katodo/pNav32_RobotMotorController/Hardware/hBridge3620_Rev1/Render/hBridge3620_Top_Normal.png

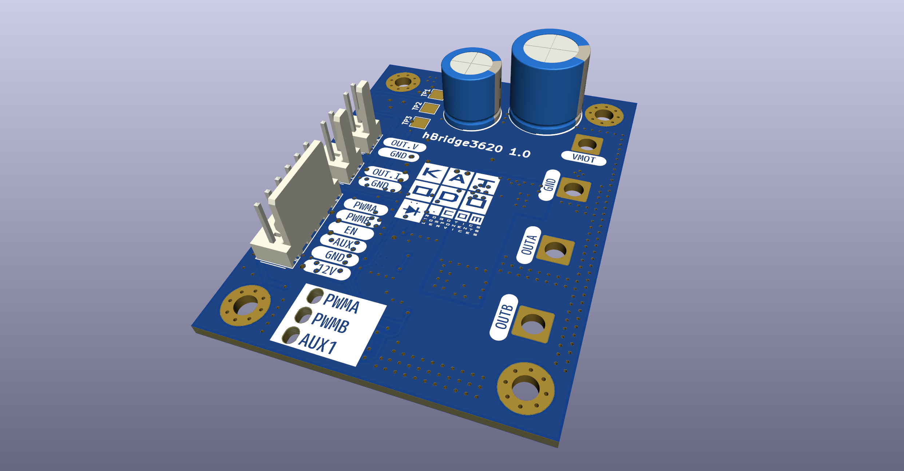
Hardware/hBridge3620_Rev1/Render/hBridge3620_Top_Normal.png
