katodo/pNav32_RobotMotorController/Hardware/RobotMotorController/Doc/F407VE板- LCD显示例程/readme.txt

本实验将实现如下功能：本实验利用STM32F407开发板连接TFTLCD模块，实现TFTLCD模块的显示，下载成功后，通过把LCD模块插入TFTLCD模块接口，按下复位之后，就可以看到LCD模块不停的显示一些信息并不断切换底色。同时该实验会显示LCD驱动器的ID，并且会在串口打印（按复位一次，打印一次）。
 
//STM32F4工程模板-库函数版本
//淘宝店铺：http://mcudev.taobao.com
