katodo/pNav32_RobotMotorController/Hardware/RobotMotorController/Doc/STM32_F4VE--核心板原理图 (EN).pdf

PIRST02

PIRST01

PIRST02

PIRST01

NLNRF0CS

PIQ201PIR3001

PIR2302PIJ305

NLPA100RXD1

NLFSMC0A18 | NLFSMC0NE1

NLFSMC0D3
NLFSMC0D1

NLFSMC0D9

NLPB30TDO

NLNRF0IRQ

NLFSMC0D5

NLPB13

NLPB10

PIJ306PIR3301

Reserve 5V input interface, connector spacing 2.54mm

STM32 working mode has been grounded by default: grounded through R7 and R8

To change the jumper cap insertion method, the board has a jumper cap by default

The jumper cap is inserted into the flash memory mode by default for the convenience of carrying the board.

It works normally, and the jumper cap does not need to be inserted. If you need other working modes, you can

NLFSMC0D15

## reset button

## LED indicator

## Power supply indicator

Power supply stabilized power supply

## User button

## STM32 working mode selection

## Real time clock battery backup

## ISP serial port download program interface

## TFT LCD screen interface

TIM4_ETR/FSMC_NBL0/PE0

3V3

104

2

10K

RST

6

PD2/UART5_RX/TIM3_ETR/SDIO_CMD

PA12/USB_DP

55

8

PB5

6

94

PE5

PB10

A

FSMC_D4

21 22

3

twenty one

9

VREF-

39 40

104

NRF_CS

OUT

68

PC10/USART4_TX/SDIO_D2/(USART3_TX)

3

PC11

PC11

KEY1

1M

104

0R

SDIO_D0

(I2C1_SDA/CANTX)/SDIO_D5/TIM4_CH4/PB9

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
FSMC_D13 PA6/ADC12_IN6/TIM3_CH1/TIM8_BKIN/SPI1_MISO/(TIM1_BKIN)

R12

D-

FSMC_NWE

TIM1_CH4/FSMC_D11/PE14

42

GND

PA5

GND

D2

VDD_2

32.768K

OSC_IN

PD5/FSMC_NWE/(USART2_TX)

VBAT

FSMC_D10

R16

C15

10K

5

PD2

R19 22

3V3

R9

FSMC_D7

80

9 10

2

RST

UART_TX

0

SW-PB

D+

PC13/TAMPER-RTC

PD1

RTCK

96

FSMC_D13

GND

3V3

500mA

21 22

TDO

FSMC_D7

PA9/USART1_TX/TIM1_CH2

FSMC_D1

PC8

PE11

J4

5

SPI2_NSS/I2S2_WS/I2S2_SMBA1/TIM1_BKIN/USART3_CK/PB12

15

3

PE15

75

VDD_5

C4

72

Q1

LASH_WP

DAT2

Vsupply

5

T_MISO

29 30

GND

TRACED0/FSMC_A19/PE3

FSMC_D14

5V

U2

48

Size

SPI1_SCK

VCC

NRF2401

T_SCK

PE1

88

NRST

PE3

33 34

PC2/ADC123_IN12

PD8

11

43 44

510R

45 46

3V3

GND

25

5 6

FSMC_NWE

PA10/RXD1

GND

PE0

7

1.5K

PA7

3

3

PA8

C12

1.5K

C:\Documents and Settings\..\STM32_F4VE.Sc Drawn B hDocy:

(TIM1_CH2N)/TIM8_CH2N/TIM3_CH3/AD12_IN8/PB0

PD15

82

VSS_4

PA11/USB_DM

R13

5V

6

4

PA4

51

41 42

4

PE6

37 38

RST

17 18

K_UP

TRACED3/FSMC_A22/PE6

PA6

FSMC_D2

4

FSMC_D10

7

PD13

PC3

PD8/FSMC_D13/(USART3_TX)

FSMC_D4

MiniSD

PB12

56

SPI1_MISO

PB3/TDO

PD9

PE6

PC5/ADC12_IN15

PE14

VCC

GND

R26

PA12/USB_DP

2017-10-24

CMD

led

95

3V3

GND

10K

SPI2_MOSI/TIM1_CH3N/PB15

FSMC_D11

6

R14

19 20

FSMC_D1

GND

PA12/USART1_RTS/TIM1_ETR/USBDP/CANTX 76

PC2

SPI1_SCK

TIM1_CH1/FSMC_D6/PE9

PA0/WK_UP

PB1

FSMC_D8

23 24

104

D1

GND

PD11/FSMC_A16/(USART3_CTS)

57

PC5

13 14

PE8

104

SPI1_MISO

1

SDIO_CMD

11 12

GND

104

VCAP_1

T_MOSI

GND

1

10K

PA15/TDI

PC9

PA1

BAT54C

8

twenty four

FSMC_D5

1

PD3

GND

(TIM3_CH1/SPI1_MISO)SPI3_MISO/JNTRST/PB4

T_SCK

PD15

SDIO_D3

PE12

R23

1 2

1

R6

92

PA2/ADC123_IN2/USART2_TX/TIM2_CH3/TIM5_CH3

1.5K

K0

15 16

35 36

3

PD14/FSMC_D0/(TIM4_CH3)

R4

106

PA0/WK_UP

PC4

30

PD0/FSMC_D2(CANRX)

PA11/USB_DM

4

8

PC8/TIM8_CH3/SDIO_D0/(TIM3_CH3)

4

PE9

PC12

10K

19 20

5

VDDA

GND

R25

PC0

12P

45 46

5 6

PA14/JTCK/SWCLK

PE13

W25Q16

FSMC_NOE

106

45

65

GND

PA4/ADC12_IN4/USART2_CK/DAC_OUT1/SPI1_NSS

93

C11

FLASH_CS

1

GND

VDDA

(USART1_RX)/FSMC_NL/I2C1_SDA/TIM4_CH2/PB7

NC

3 4

9 10

25 26

10K

510R

PA6

5V

USB

U5

BOOT0 BOOT1 Boot Mode

TIM1_CH3N/FSMC_D9/PE12

FSMC_D2

PA0/WK_UP

PD12

31 32

13 14

SPI1_MOSI

J1

C5

7

3V3

FSMC_D5

5V

twenty one

25 26

GND

PD0

9

PC11/USART4_RX/SDIO_D3/(USART3_RX)

NRF_IRQ

79

15

PD6

11

PB15

3V3

R8

C21

Header 16X2

PB11

PC6

FSMC_D11

PA7/ADC12_IN7/TIM3_CH2/TIM8_CH1N/SPI1_MOSI(TIM1_CH1N)

FSMC_A18

27

6

SW-PB

20

C3

59

VDD_3

PA2

GND

Vref
nTRST

FSMC_NE1

TIM1_BKIN/FSMC_D12/PE15

104

GND

FSMC_D14

PD3/FSMC_CLK/(USART2_CTS)

39

R1

PE10

GND

FSMC_NBL1/PE1

PD10

LCD_RESET#

PD10

104

PE13

1

PC14/OSC32_IN

FSMC_D14

GND

T_CS

PA9/TXD1

PA7

29

9

17

PD7

PC0/ADC123_IN10

7 8

SW-PB

T_SCK

66

KEY0

NRF_CS

A2

PA15/TDI

SDIO_D1

(TIM2_CH3)/I2C2_SCL/USART3_TX/PB10

PE14

83

PC14

PE4

C17

PD7

LCD_BL

PA3

GND

PE12

PC6

GND

NCC

13

C7

VSS_2

52

3V3

P1

13 14

TRACED1/FSMC_A20/PE4

GND

23 24

8M

3V3

PD6/FSMC_NWAIT/(USART2_RX)

74

ISP_COM

FSMC_D8

PB11

CS F_CS

PE7

39 40

3 4

PA12/USB_DP

106

FSMC_D8

37

PA10/RXD1

86

D

6

PB4/TRST

SDIO_CMD

R31

PA7

SPI1_MISO

Number

OSC_OUT

B1

84

510R

16

SPI2_SCK/I2S2_CK/TIM1_CH1N/USART3_CTS/PB13

PD5

3

CD/DAT3

nSRST

PA10/USART1_RX/TIM1_CH2 | FSMC_D5

PC9

PB3/TDO

FSMC_D12

19 20

T_PEN

TIM1_ETR/FSMC_D4/PE7

8

27 28

22R

U1

PB8

VREF+

PD9/FSMC_D14/(USART3_RX)

FSMC_D2

GND

R3

PB13

1

PE5

CLK

NC

T_MISO

38

BOOT0

NRF_IRQ

GND

2

PD3

FSMC_D3

FSMC_D11

PE2

PC3/ADC123_IN13

B

19

90

PB14

27 28

CLK

PA15/TDI

10K

62

FSMC_NOE

PA13/JTMS/SWDIO
53

PD2

GND

22

1

PD14

SDIO_D2

PD11

FSMC_D9

SW-PB

104

PA1/ADC123_IN1/USART2_RTS/TIM2_CH2/TIM5_CH2

98

VSS_5

1.5K

C24

KEY1

BOOT0

J2

SDIO_SCK

6

twenty three

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
FLASH_CLK

13

SPI1_MOSI

R17

PC6/TIM8_CH1/I2S3_MCK/SDIO_D6/(TIM3_CH1)

3V3

PB12

PA9/TXD1

33 34

510R

87

C6

C8

10

60

LCD_BL

(TIM3_CH2/SPI1_MOSI)/SPI3_MOSI/I2C1_SMBA1/I2S3_SD/PB5

T_MOSI

FSMC_NOE

1 2

8

PD14

VCAP_2

PB15

HOLD

PB10

1

BOOT1/PB2

3V3

PA10/RXD1

C23

3

C

PE1

Header 24X2

led

GND

FSMC_NWE

ZET6 uses FSMC_NE4

PD12/FSMC_A17/(USART3_RTS/TIM4_CH1)

40

R7

15 16

PB7

Sheet of

PB4/TRST

TIM1_CH2N/FSMC_D7/PE10 PD11

F_CS

FSMC_D6

16

PE4

GND

5

VDD

D

C22

PC10

VCC

3V3

PC9/TIM8_CH4/SIDO_D1(TIM3_CH4)

25 26

77

10K

DAT0

PB7
5

85

Revision

PB9

R29

2

36

FSMC_D3

31 32

C16

7

3V3

VDD_1

7 8

SDIO_D2

PA5/ADC12_IN5/DAC_OUT2/SPI1_SCK FSMC_D15

TIM1_CH3/FSMC_D10/PE13

FSMC_D0

12

1

PA1

58

0 don't care

R35

47 48

10K

PD15/FSMC_D1/(TIM4_CH4)

41

GND

T_CS

PNP

R10

5

91

PD1/FSMC_D3/(CANTX)

18

11 12

49

Y2

3

26

14

1

UART_RX

7 8

PA8

3V3

NRF_CE

Title

PB2/BOOT1

R24

GND

106

C14

4

R28

(I2C1_SCL/CANRX)/SDIO_D4/TIM4_CH3/PB8

PA15/JTDI/I2S3_WS/SPI3_NSS/(TIM2_CH1_ETR/SPI1_NSS)

PD5

FSMC_D15

PC13

12P

PB0

14

T_CS

Internal RAM

27 28

PA2

PE11

10K

TDI

R11

GND

33

TRACECLK/FSMC_A23/PE2

C2

70

PE10

10K

1

FSMC_D6

BOOT0

3V3

PC12

R34

STM32F407VET6

3V3

R2

FSMC_D12

PA13/TMS

PD4/FSMC_NOE(USART2_RTS)

4

Y1

FSMC_NE1

TCK

69

10K

PC12/UART5_TX/SDIO_CK/(USART3_CK)

GND

3V3

8

LASH_DO

GND

104

PA4

TMS

(TIM2_CH4)/I2C2_SDA/USART3_RX/PB11

RST

64

PA13/TMS

100

2

PB3/TDO

35 36

104

PC10

FSMC_D9

10K

PA8/USART1_CK/TIM1_CH1/MCO

R30

FSMC_D0

SDIO_D0

R33

31 32

19

3V3

JP2

PD12

VDD_4

43

510R

PA3

41 42

PE4

PD7/FSMC_NE1/FSMC_NCE2/(USART2_CK)

ARM_JTAG

FSMC_D6

KEY0

17 18

Date:

PA11/USB_DM

PC0

C1

NC

FSMC_D9

PC7

47

GND

PB13

PE0

FSMC_D15

PC15/OSC32_OUT

PA14/TCK

PC1/ADC123_IN11

89

C9

9 10

VREF

7

1

7

SPI2_MISO/TIM1_CH2N/USART3_RTS/PB14

FSMC_D13

73

J3

SO

5 6

GND

PA11/USART1_CTS/TIM1_CH4/USABDM/CANRX

PD13

PA14/TCK

FSMC_D3

SDIO_D1

PD8

R32

31

RST

3V3

PA0/WKUP/ADC123_IN0/USART2_CTS/TIM2_CH1_ETR/TIM5_CH1/TIM8_ETR

106

VSS_3

PE15

2

TRACED2/FSMC_A21/PE5

J6

15 16

1

GND

50

2

71

PC5

FSMC_D12

PE3

PD4

PC15

VREF+

3V3

VBAT

PD0

PC8

NC

VBAT

PE7

PE2

67

PA9/TXD1

VREF-

PC4/ADC12_IN14

PD9

SPI1_SCK

18

37 38

PE9

PB5

D3

28

0R

Header 24X2

(TIM1_CH3N)/TIM8_CH3/TIM3_CH4/ADC12_IN9/PB1

32

3V3

GND

17 18

BAT

PB14

PD1

(TIM2_CH2/SPI1_SCK)/SPI3_CLK/TRACESWO/I2S3_CK/JTDIO/PB3

FSMC_A18

R27

35

3

C20

SI

AMS1117-3.3V

VREF+

FSMC_D10

10K

PB0

TIM1_CH1N/FSMC_D5/PE8

21 22

3V3

34

22P

SPI1_MOSI

GND

0R

22P

10K

GND

104

GND

FSMC_D0

PD10/FSMC_D15/(USART3_CK)

PC4

PC13

R20

10

NRF_CE

PC7/TIM8_CH2/I2S3_MCK/SDIO_D7(TIM3_CH2)

20

43 44

PB2/BOOT1

R22

29 30

11 12

4

104

PB8

47 48

PD6

2

C13

PB6

46

FSMC_D7

2

R5

3 4

104

63

TIM1_CH2/FSMC_D8/PE11

LCD_BL

FSMC_D4

97

17

29 30

106

C19

Q2

10K

PD13/FSMC_A18/(TIM4_CH2)

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
SDIO_D3

PB1

FSMC_D1

R18 22

99

PB6

54

3

5V

DAT1

File:

PD4

(USART1_TX)/I2C1_CLK/TIM4_CH1/PB6

PENIRQ

44

12

SDIO_SCK

C18

WP

4

23 24

GND

PA3/ADC123_IN3/USART2_RX/TIM2_CH4/TIM5_CH4

FLASH_DIO

PC3

In SWD debugging mode, this IO is available

In SWD debugging mode, this IO is available

NLT0SCK

NLBOOT0

NLT0PEN

NLT0CS

NLPC10

NLPC12

NLPB11

NLF0CS

NLPA140TCK

NLVBAT

NLT0MISO

CORST

FSMC_A18 | FSMC_NE1

## T_MOSI

ISP download mode

## T_PEN

## T_MISO

## User flash

## ZET6 uses A6

PIR902COR9

PIR702

PIR701

PIR902

PIR701

PIR702COR7

NLVREF0

NLSPI10MOSI

NLPB40TRST

NLKEY0

NLKEY1

NLT0MOSI

NLVREF0

NLPC6

NLPC2

NLSDIO0D1

NLSDIO0D0

NLSDIO0D3

## Reserved IO interface

## Introduction to CPU

## JTAG/SWD debug interface

External storage FLASH | NRF2401 Wireless Module Interface | STM32-USB Slave interface
| NLFSMC0D6

NLPC4

NLPC0

NLPC1

NLPC7

NLPC3

NLPD0

NLPD8

NLPB8

NLPE7

NLPA4

NLPA7

NLPD1

NLPA8

NLPB9

NLPD9

NLPE8

NLPD2

NLPE4

| NLPC8

NLPE1

NLPD7

NLPC9

NLPA3

NLPA5

NLPD5

NLPC5

NLPB5

NLPE3

NLPE0

NLPB0

NLPE9

NLPB1

NLPA1

NLPD3

NLPA6

NLPD4

NLPB7

NLPE5

NLSPI10MISO

NLFSMC0NWE
NLPA150TDI

NLSPI10SCK

NLFSMC0D7

NLPA00WK0UP

PIR502

PIR502COR5

NLFSMC0D14

NLSDIO0CMD

NLFSMC0NOE

PIR501

PIR501

NLPD10

NLPD13 | NLPE13

NLPB14

NLPC13

NLPE10

NLPB15

NLPA110USB0DM

PIR901

NLPA120USB0DP

## STM32F407xxx core board

## STM32F407xxx core board

## Embedded development network boutique mcudev.taobao.com produced

## Embedded development network boutique mcudev.taobao.com produced

NLNRF0CE

NLLCD0BL

NLSDIO0D2

# STM32F407VET6

# Core: ARM 32-bit Cortex-M4

# RAM: 196K FLASH: 512K

## CPU working frequency up to 168MHz

NLPA90TXD1

NLFSMC0D11

NLFSMC0D13

NLPA130TMS

NLSDIO0SCK

NLPB20BOOT1

NLFSMC0D4

NLFSMC0D8

NLFSMC0D2
NLFSMC0D0

NLRST

NLPD6 | NLPE6 NLPE2

NLPA2

NLPB6
NLFSMC0D12
NLFSMC0D10
NLPD12 | NLPE12

NLPE14

NLPC14

NLPD15

NLPD11 | NLPE11

NLPE15

NLPB12

NLPC11

NLPD14

NLPC15

# Machine Translated by Google

# PAJ40

## CORST

PAU502PAU503PAU504 PAU503PAU504PAU505PAU506 PAU507PAU508PAU509 |

PARST02

PAJ405PAJ404PAJ403PAJ402PAJ401 PAJ403PAJ402PAJ401

PAJ40

PARST01

# Header, 4-Pin

## RES

crystal oscillator

1

# JTAG

# Cap, Cap, Cap, Cap

# Capacitor

R22

# SOT-23-BAT54C

1

2

RC0603

# Resistor

# HDR1X4

5

J1

6

1

# LibRef

Res2, Res2, Res2,

# SOT-223

1

# TF_SD

P1

## USB

# Capacitor, Capacitor

Resistor, Resistor,

# PNP

# Header 4

C2, C5, C18, C21, C22,

RC0603

3

# row

# R11, R34, R35

# Semi, CAP, Cap

C1, C3, C4, C6, C7,

# Res2

11

# SW-PB

Capacitor, Capacitor,

10K | Res2, Res2, Res2, Res,

1

RC0603

# AMS1117-3.3V

12P

# Quantity

Resistor, Resistor,

U2

1M

1

Q1

8M

JZ32768

# IDE2X4

# led

# SW-SPST

# (Semiconductor SIM

1

# R5, R13, R14, R23, R33 RC0603

# SOP8L

# Mini_USB

R20, R24, R26, R27,

# D1, D2, D3

500mA

RC0603

JP2

106

# CRYSTAL

[NoValue], [NoValue],

[NoValue], [NoValue],

## RES

# ISP_COM

# IDE2X16

Cap, CAP, CAP, CAP,

JTAG-20P | 1

# Header 16X2

Cap, Cap, Cap, Cap,

R10

R18, R19

# Resistor

## RES

# Header 4X2

R28, R29

2

Model), [NoValue],

NC

Capacitor, Capacitor,

RC0805

# Footprint

[NoValue], [NoValue], | RES, RES, RES, RES,

# Res2

# K0, K1, K_UP, RST

1

Capacitor, Capacitor,

1

RC0603

U1

# CRYSTAL

# Header 24X2

# BAT

1

# Header, 4-Pin, Dual

2

C8, C9

R1, R2, R3, R4, R6,

twenty two

# Description

1

1

Resistor, Resistor,

J6

Y1

# Cap, Cap, Cap, Cap

# R17, R21, R30, R32

# Header 24X2

## RES

C16, C17, C19, C20,

# BAT54C

# MiniSD

# ARM_JTAG

# Header, 16-Pin, Dual

# Crystal

## CAP

Capacitor, Capacitor,

510R

## CAP

R7, R8, R9, R12, R16,

# Capacitor, Capacitor

# BATTERY

22R

32.768K

# NRF2401

# Resistor, Resistor

# row

C10, C11

Y2

1

# Designator

1

14

4

R31

## USB

# Header 16X2

C23

# Resistor

# MiniSD

RC0603

## RES

# BAT54C

4

# PNP Bipolar Transistor Q2

J2, J3

C24

Resistor, Resistor,

U3

# JTAG

# PNP_SOT23

# Header, 24-Pin, Dual

104

RC0603

# row

R25

3

RC0603

Capacitor, Capacitor,

STM32F407VET6 | STM32F407VET6

0R

# 49S_SMD

1

1

22P

Res2, Res2, Res2,

# BAT

# IDE2X24

# led

[NoValue], Resistor,

B1

# Comment

U5

1.5K

1

# PNP

J4

RC0805

ELECTRO2, ELECTRO2,

RC0603

W25X16

2

C12, C13, C14, C15,

16

RC0603

# SW-PB

# Res2

# Capacitor

# LED0805

Capacitor, Capacitor,

# Res2, Res2

W25Q16
