katodo/pNav32_RobotMotorController/Hardware/RobotMotorController/Doc/STM32_F4VE--核心板原理图 (ITA).pdf

PIR901

NLPA110USB0DM

NLPE10

NLPB15

NLPD13 | NLPE13

NLPC13

NLPD10

NLPB14

PIR501

PIR501

PIR502 PIR502COR5

NLFSMC0D14

NLSDIO0CMD

NLFSMC0NOE

NLFSMC0D7

NLPA00WK0UP

NLFSMC0NWE
NLPA150TDI

NLSP10SCK

NLSP10MISO

NLPC1

NLPC0

NLPC7

NLPC4

NLPC3

NLPD5

NLPB0

NLPD1

NLPA6

NLPB1

NLPA1

NLPC5

NLPA5

NLPB7

NLPE1

NLPC8

NLPD0

NLPC9

NLPE0

NLPD3

NLPD9 | NLPE9 NLPE5

NLPD7

NLPA3

NLPE4

NLPD8

NLPD2

NLPB8

NLPE7

NLPA4

NLPD4

NLPA7

NLPE3

NLPB9

NLPA8

NLPB5

NLPE8

## Interfaccia di debug JTAG/SWD

Memoria esterna FLASH | STM32-interfaccia Slave USB

## Introduzione alla CPU

## Interfaccia I/O riservata Interfaccia modulo wireless NRF2401

| NLFSMC0D6

NLSDIO0D1

NLSDIO0D0

NLSDIO0D3

NLPC2

NLPC6

NLPB6

NLPE6

NLPE2

NLPA2

NLPD6

NLRST

NLFSMC0D10

NLFSMC0D12

NLFSMC0D0

NLFSMC0D2

NLFSMC0D4

NLFSMC0D8

NLPC11

NLPD12

NLPE14

NLPD15

NLPD11 | NLPE11
| NLPE12

NLPE15

NLPB12

NLPD14

NLPC15

NLPC14

NLPB20BOOT1

# RAM: 196K FLASH: 512K

Frequenza di lavoro della CPU fino a 168 MHz

# Core: ARM Cortex-M4 a 32 bit

# STM32F407VET6

NLPA90TXD1

NLFSMC0D11

NLPA130TMS

NLSDIO0SCK

NLFSMC0D13

NLSDIO0D2

NLNRF0CE

NLLCD0BL

NLPA120USB0DP

## Scheda base STM32F407xxx

## Scheda base STM32F407xxx

## Boutique di rete di sviluppo integrata mcudev.taobao.com prodotta

## Boutique di rete di sviluppo integrata mcudev.taobao.com prodotta

Per modificare il metodo di inserimento del cappuccio del ponticello, la scheda dispone di un cappuccio del ponticello per impostazione predefinita

La modalità di lavoro STM32 è stata messa a terra per impostazione predefinita: messa a terra tramite R7 e R8

Il cappuccio del ponticello è inserito nella modalità memoria flash di default per la comodità di trasportare la scheda.

Funziona normalmente e non è necessario inserire il cappuccio del ponticello.Se hai bisogno di altre modalità di lavoro, puoi farlo

Riserva interfaccia di ingresso 5V, distanza connettori 2,54 mm

PIJ306PIR3301

NLPB30TDO

NLFSMC0D5
NLFSMC0D3

NLFSMC0D9

NLFSMC0D1

NLNRF0IRQ

NLFSMC0A18 | NLFSMC0NE1

NLPB13

NLPB10

NLPA100RXD1

PIR2302PIJ305

PIQ201PIR3001

PIRST02

PIRST01

PIRST02

PIRST01

NLNRF0CS

NLVREF0

NLKEY1
NLKEY0

NLPB40TRST

NLT0MOSI

NLVREF0

NLSP10MOSI

PIR702COR7

PIR701

PIR902

PIR702

PIR701

PIR902COR9

CORSO

FSMC_A18 | FSMC_NE1

Modalità di download dell'ISP

Flash utente

T_MOSI | T_MISO
T_PEN

ZET6 utilizza A6

NLVBAT

NLPA140TCK

NLT0MISO

NLT0CS

NLPB11

NLF0CS

NLPC12
NLPC10

NLT0SCK

NLBOOT0

NLT0PEN

Nella modalità di debug SWD, questo IO è disponibile

Nella modalità di debug SWD, questo IO è disponibile

GND

PE3

W25Q16

106

4

29 30

4

PC8/TIM8_CH3/SDIO_D0/(TIM3_CH3)

8

NRF_CE

K1

2

GND

VDD

PC0

C8

PB2/BOOT1

C11

R4

USB

PD13/FSMC_A18/(TIM4_CH2)

Q2

10.000

47 48

97

PA6

29 30

11 12

R22

12

C18

GND

FSMC_A18

(TIM3_CH1/SPI1_MISO)SPI3_MISO/JNTRST/PB4

PD15

PB14

3V3

FLASH_DIO

3V3

GND

32

PA2/ADC123_IN2/USART2_TX/TIM2_CH3/TIM5_CH3

PC3

R6

PB12

WP

23 24

104

ventiquattro

FSMC_D5

8

B

15

78

VREF+

22P

104

R20

3V3

R8

54

Intestazione 16X2

GND
PE11

FSMC_D5

PE5

7

PB10

C5

Q1

LASH_WP

NRF_CS

9

PC11/USART4_RX/SDIO_D3/(USART3_RX)

PC11

3 4

PA6

10.000

510R

PD6

2

VREF+

FSMC_D4

PA0/WK_UP

63

TIM1_CH2/FSMC_D8/PE11 PD12

U5

PD1

BAT

FSMC_NOE

106

45

PD4

PE13

SDIO_SCK

PENIRQ

(USART1_RX)/FSMC_NL/I2C1_SDA/TIM4_CH2/PB7

3

C20

SI

1

PA4/ADC12_IN4/USART2_CK/DAC_OUT1/SPI1_NSS

VDDA

GND

17 18

0R

22P

5

SW-PB

D+

T_SCK

21 22

500 mA

PE14

SDIO_D1

(TIM2_CH3)/I2C2_SCL/USART3_TX/PB10

B

PA15/TDI

GND

104

GND

96

1M

PC14/OSC32_IN

FSMC_D14

GND

GND

U3

PD7

17

9

29

PC0/ADC123_IN10

0

3V3

0R

PA9/TXD1

D-

TIM1_CH4/FSMC_D11/PE14

Vref
nTRST

FSMC_NWE

R16

GND

Dimensione

TIM4_ETR/FSMC_NBL0/PE0

PD10

SPI1_SCK

R1

6

PD2/UART5_RX/TIM3_ETR/SDIO_CMD

104

GND

RST

PA12/USB_DP

39

5

FSMC_A18

PC7

FSMC_D13 PA7/ADC12_IN7/TIM3_CH2/TIM8_CH1N/SPI1_MOSI(TIM1_CH1N)

OSC_IN

R12

59

VDD_2

32.768K

R19 22

PD2

VREF-

ventuno

16

SPI2_SCK/I2S2_CK/TIM1_CH1N/USART3_CTS/PB13

510R

75

SW-PB

21 22

3 | PC8

3

PC8

nSRST

PA10/USART1_RX/TIM1_CH2

FSMC_D7

CD/DAT3

104

39 40

9

86

PA0/WK_UP

PA10/RXD1

37

5 6

PB1

PA7

PE8

104

1.5K

SPI1_MISO

PB4/TRST

SDIO_CMD

ISP_COM

FSMC_D10

PD5/FSMC_NWE/(USART2_TX)

VBAT

PA13/TMS

Y1

1

PD10

80

FSMC_D8

106

PA5

GND

C4

72

VDD_5

GND

29 30

T_MISO

PA3

C16

PB5

8

TRACED0/FSMC_A19/PE3

P1

FSMC_D14

48

J6

3V3

4

106

FSMC_D15 PA6/ADC12_IN6/TIM3_CH1/TIM8_BKIN/SPI1_MISO/(TIM1_BKIN)

C14

portato

PB0

D2

VDD_1

GND

12P

TIM1_CH3/FSMC_D10/PE13

42

0 non importa

FSMC_D0

3V3

CHIAVE1

7 8

PC13

PD5

SDIO_D0

FSMC_D15

(I2C1_SDA/CANTX)/SDIO_D5/TIM4_CH4/PB9

PA15/JTDI/I2S3_WS/SPI3_NSS/(TIM2_CH1_ETR/SPI1_NSS)

47 48

R25

GND

UN

94

FSMC_D4

R34

STM32F407VET6

3V3

6

FUORI

68

25 26

PC10/USART4_TX/SDIO_D2/(USART3_TX)

3V3

LASH_DO

2

104

T_CS

PD15/FSMC_D1/(TIM4_CH4)

PNP

NRF_CE

Titolo

18

PD1/FSMC_D3/(CANTX)

10.000

91

55

11 12 | RAM interna

27 28

5

T_CS

PE12

Vfornitura

Revisione

33

7

70

5V

U2

TRACECLK/FSMC_A23/PE2

VREF+

3

15

5

SPI2_NSS/I2S2_WS/I2S2_SMBA1/TIM1_BKIN/USART3_CK/PB12

PE15

PD4

64

FSMC_D1

SDIO_D0

TDO

FSMC_D9 PA9/USART1_TX/TIM1_CH2

R30

PD0

VBAT

DAT2

VDD_4

PC15

37 38

69

PC13/TAMPER-RTC

PD1

NRF_IRQ

FSMC_D13

GND

RTCK

2

GND

R10

RST

9 10

UART_TX

49

1

R21

10.000

VDD

FSMC_D12

PD4/FSMC_NOE(USART2_RTS)

GND

3V3

FSMC_D7

PC12

R9

1

3V3

3V3

C22

D

106

TRACED2/FSMC_A21/PE5

15 16

PE15

2

PD9

PE4

FSMC_D6

MiniSD

PC5

PD7/FSMC_NE1/FSMC_NCE2/(USART2_CK) 56

1

PA11/USB_DM

NC

4

FSMC_D10

Data:

R32

VSS_3 | PC0

31

17 18

RST

(TIM1_CH2N)/TIM8_CH2N/TIM3_CH3/AD12_IN8/PB0

CHIAVE0

6

2

R13

50

PA4

71

GND

FSMC_NWE

25

PA10/RXD1

VREF-

0R

Intestazione 24X2

100

3

PA7

3

1.5K

PE9

J3

73

PE0

88

VCC

47

NRST

COSÌ

5 6

PC2/ADC123_IN12

PD8

9 10

11

R33

PE3

GND

31 32

NRF2401

1

PA3

GND

45 46

41 42

510R

PB9

C

104

2

FSMC_D10

TIM1_CH1N/FSMC_D5/PE8

34

PB6

C12

R18 22

99

21 22

File:

PD10/FSMC_D15/(USART3_CK)

57

GND

FSMC_D0

PC4

PC13

PB13

PC7

6

10.000

SPI2_MOSI/TIM1_CH3N/PB15

C9

1

FSMC_D11

R14

41 42

VREF

FSMC_D3

GND

PA12/USART1_RTS/TIM1_ETR/USBDP/CANTX PA14/TCK

SDIO_D1

PE6

PC5/ADC12_IN15

PB3/TDO

PA4

104

SPI1_SCK

PC10

35 36

104

4

95

C6

CMD

portato

R26

28

D3

PB5

19

3V3

PD13

FSMC_D15

PC15/OSC32_OUT

T_CS

8M

3V3

CS

GND

PA14/TCK

89

PC1/ADC123_IN11

7 8

39 40

3 4

PA12/USB_DP

104

PE13

1

PD8

ARM_JTAG

FSMC_D8

74

PD6/FSMC_NWAIT/(USART2_RX)

PB11

PA7

SW-PB

FSMC_D9

C1

PD5

OSC_OUT

B1

FSMC_D0

10.000

FSMC_D11 PA8/USART1_CK/TIM1_CH1/MCO

3

C3

43

VDD_3

13

C7

NCC

TMS

23 24

2

PB3/TDO

66

CHIAVE0

GND

PA13/TMS

83

F_CS

RST

(TIM2_CH4)/I2C2_SDA/USART3_RX/PB11

PC14

PE7

PC4/ADC12_IN14

B

18

90

PA2

GND

67

PA9/TXD1

PE10

GND

R31

3V3

PD12

VCAP_2

1 2

8

FSMC_D3

FSMC_D12

PE2

PA10/RXD1

C23

VBAT

PE7

NC

T_MISO

PRESA

PB10

VSS_2

3V3

NRF_CS

52

PA0/WKUP/ADC123_IN0/USART2_CTS/TIM2_CH1_ETR/TIM5_CH1/TIM8_ETR

27

A2

PD7

PE4

C17

LCD_BL

GND

PC6

GND

TRACED1/FSMC_A20/PE4

6

13 14

7

FSMC_D13

SPI2_MISO/TIM1_CH2N/USART3_RTS/PB14

84

PB11

PC11

PC6

7

PD13

GND

PA11/USART1_CTS/TIM1_CH4/USABDM/CANRX

FSMC_D5

20

46

2

FSMC_D7

33 34

R17

PC7/TIM8_CH2/I2S3_MCK/SDIO_D7(TIM3_CH2)

20

SPI1_MOSI

PA15/TDI

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
TIM1_ETR/FSMC_D4/PE7

FSMC_D12

10.000

AMS1117-3.3V

PB0

19 20

3V3

T_PEN

8

C

PE1

PD9/FSMC_D14/(USART3_RX)

PE5

PB7

FSMC_D2
PB13

GND

Intestazione 24X2

Foglio di

10.000

(TIM2_CH2/SPI1_SCK)/SPI3_CLK/TRACESWO/I2S3_CK/JTDIO/PB3

FSMC_NOE

PD2

SDIO_D2

53

C10

VSS_5

98

(TIM1_CH3N)/TIM8_CH3/TIM3_CH4/ADC12_IN9/PB1

PC1

FLASH_CLK

2

R27

35

J2

6

PA9/TXD1

3V3

PD3

2

NRF_IRQ

44

T_MOSI

(USART1_TX)/I2C1_CLK/TIM4_CH1/PB6

LCD_BL

FSMC_NOE

CLK

27 28

3V3

PA3/ADC123_IN3/USART2_RX/TIM2_CH4/TIM5_CH4

4

GND

5

PC1

SPI1_MOSI

PC10

GND

DAT1

77

3

5V

SDIO_D3

GND

61

PB1

FSMC_D1

R7

PD12/FSMC_A17/(USART3_RTS/TIM4_CH1)

C19

ZET6 utilizza FSMC_NE4

15 16

C24

CHIAVE1

BOOT0

43 44

81

17

1

PA5

NC

7 8

3

27 28

T_MOSI

PB8

UN

22R

R5

portato

C13

1

PB3/TDO

PC9

LCD_BL

FSMC_D6

TIM1_CH2N/FSMC_D7/PE10

82

VSS_4

104

PA1/ADC123_IN1/USART2_RTS/TIM2_CH2/TIM5_CH2

PC2

19 20

SPI1_SCK

SDIO_SCK

4

5V

ventitré

51

GND

62

PB6

PD15

PA11/USB_DM

10.000

10

FSMC_D9

SW-PB

76

FSMC_D1 PA13/JTMS/SWDIO

PD14

PA6

FSMC_D2

FSMC_D11

PD14

7

VCAP_1

104

CLK

PE1

38

NC

T_SCK

BOOT0

19

PE14

PC3/ADC123_IN13

PD9

VCC

U1

PB15

TRACED3/FSMC_A22/PE6

RST

17 18

K_UP

GND

PC3

R3

PE6

FSMC_D4

GND

PB12

PD8/FSMC_D13/(USART3_TX)

PA12/USB_DP

2017-10-24

1 2

PE0

D1

GND

7 | PA8

F_CS

FSMC_D8

TIM1_CH1/FSMC_D6/PE9
PD11

PB4/TRST

23 24

C:\Documenti e impostazioni\..\STM32_F4VE.Sc Drawn B hDocy:

PC5

PD11/FSMC_A16/(USART3_CTS)

GND

FSMC_NWE

40

13 14

ventuno

T_SCK

(TIM3_CH2/SPI1_MOSI)/SPI3_MOSI/I2C1_SMBA1/I2S3_SD/PB5

1

PD3

60

SDIO_D3

5V

SPI1_MOSI

3

1.5K

92

1

BOOT1/PB2

3V3

PB14

25 26

GND

PC6/TIM8_CH1/I2S3_MCK/SDIO_D6/(TIM3_CH1)

SPI1_MISO

37 38

13

510R

87

3V3

PD11

JP2

PE3

33 34

1.5K

1

11 12

PC2

SDIO_CMD

3V3

43 44

510R

PE2

GND

2

PE8

PD14/FSMC_D0/(TIM4_CH3)

41

10.000

25 26

9 10

PD0/FSMC_D2(CANRX)

31 32

13 14

30

PA11/USB_DM

PA5/ADC12_IN5/DAC_OUT2/SPI1_SCK 93

GND

3

K0

SDIO_D2

15 16

35 36

5V

PA0/WK_UP

PC4

106

58

BOOT0 BOOT1 Modalità di avvio

1

FSMC_D2

12

PA1

TIM1_CH3N/FSMC_D9/PE12

PB9

R29

R11

10.000

DAT0

5

85

PB7

PA15/TDI

C21

PC9

10.000

31 32

36

FSMC_D3

2

4

5

10.000

16

PE4

PE9

VDDA

3 4

PC9/TIM8_CH4/SIDO_D1(TIM3_CH4)

VCC

12P

FLASH_CS

R23

PE12

FSMC_D14

PD3/FSMC_CLK/(USART2_CTS)

R2

J4

FSMC_D6

BOOT0

J1

GND

1

8

TCK

10.000

PD0

FSMC_NE1

PC12/UART5_TX/SDIO_CK/(USART3_CK)

79

TDI

D

TIM1_BKIN/FSMC_D12/PE15

14

FSMC_NE1

PA2

PE11

Numero

SPI1_MISO

10.000

C2

LCD_RESET#

FSMC_NBL1/PE1

PE10

6

C15

R24

PC12

GND

PB2/BOOT1

65

5 6

45 46

R28

NC

(I2C1_SCL/CANRX)/SDIO_D4/TIM4_CH3/PB8

PA14/JTCK/SWCLK

19 20

R35

GND

14

PD6

11

PA1

10.000

3

UART_RX

26

7 8

Y2

BAT54C

5

PA8

PB15

3V3

## Indicatore LED

## tasto reset

## Indicatore di alimentazione

## Alimentazione stabilizzata

## Pulsante utente

Interfaccia del programma di download della porta seriale dell'ISP

## Selezione modalità di lavoro STM32

## Interfaccia schermo LCD TFT

Backup della batteria dell'orologio in tempo reale

NLFSMC0D15

# Machine Translated by Google

## CORSO

PAU502PAU503PAU504 PAU503PAU504PAU505PAU506 PAU507PAU508PAU509 |
| PARST02

PAJ40

PARST01

PAJ405PAJ404PAJ403PAJ402PAJ401 PAJ403PAJ402PAJ401

# PAJ40

104

condensatore, condensatore,

## STM32F407VET6

10.000 | Ris2, Ris2, Ris2, Ris,

1

RC0603

## AMS1117-3.3V

12P

## Quantità

JZ32768

U2

Resistore, Resistore,

1M

Q1

## Intestazione 4

1

C2, C5, C18, C21, C22,

RC0603

3

## PNP

## SW-PB

riga

## Semi, CAP, Cap

C1, C3, C4, C6, C7,

## Ris2

## R11, R34, R35

11

Ris2, Ris2, Ris2,

## HDR1X4

J1

6

1

## LibRef

5

## TF_SD

Resistore, Resistore,

1

P1

## USB

## Condensatore, condensatore

## SOT-223

R22

## RES

## JTAG

1

## Berretto, Berretto, Berretto, Berretto

## Condensatore

RC0603

## SOT-23-BAT54C

1

2

## Resistore

RC0805

## Orma

RES, RES, RES, RES,

## Ris2

[Nessun valore], [Nessun valore],

## K0, K1, K_UP, RST

1

condensatore, condensatore,

U1

RC0603

1

## Intestazione 24X2

## CRISTALLO

## Intestazione 16X2

Tappo, Tappo, Tappo, Tappo,

Resistore | R10

## RES

## JTAG-20P

## Intestazione 4X2

2

Modello), [Nessun valore],

NC

condensatore, condensatore,

R28, R29

[Nessun valore], [Nessun valore],

JP2

106

## CRISTALLO

[Nessun valore], [Nessun valore],

RC0603

R18, R19

1

## RES

## ISP_COM

## IDE2X16

Berretto, Berretto, Berretto, Berretto,

8M

## R5, R13, R14, R23, R33 RC0603

## SW-SPST

## IDE2X4

portato

## (SIM semiconduttore

1

## SOP8L

R20, R24, R26, R27,

## Mini_USB

## D1, D2, D3

14

500 mA

R31

4

## USB

## Intestazione 16X2

C23

## MiniSD

RC0603

## Resistore

## BAT54C

## RES

## CAP

## Condensatore, condensatore

## BATTERIA

22R

R7, R8, R9, R12, R16,

## NRF2401

32.768K

riga

C10, C11

1

## Designatore

Y2

## Resistore, Resistore

1

## BAT54C

## Intestazione 24X2

## RES

C16, C17, C19, C20,

## R17, R21, R30, R32

510R

## MiniSD

## ARM_JTAG

## Intestazione, 16 pin, doppia

## Cristallo

## CAP

condensatore, condensatore,

## BAT

R1, R2, R3, R4, R6,

1

## Intestazione, 4 pin, doppia

2

C8, C9

ventidue
1

## Descrizione

Y1

Resistore, Resistore,

1

J6

## Berretto, Berretto, Berretto, Berretto

C12, C13, C14, C15,

RC0603

16

## SW-PB

## Ris2

## Condensatore

## LED0805

condensatore, condensatore,

## Ris2, Ris2

W25Q16

## Intestazione, 4 pin

## IDE2X24

portato

oscillatore a cristallo

B1

## Commento

U5

[Nessun valore], Resistenza,

1.5K

1

J4

ELETTRO2, ELETTRO2,

RC0603

W25X16

RC0805

## PNP

2

riga

## STM32F407VET6

3

RC0603

condensatore, condensatore,

## 49S_SMD

RC0603

0R

Ris2, Ris2, Ris2,

1

1

22P

## BAT

U3

4

Resistore, Resistore,

## Transistor bipolare PNP Q2

J2, J3

C24

R25

## PNP_SOT23

## JTAG

## Intestazione, 24 pin, doppia
