katodo/pNav32_RobotMotorController/Firmware/adc_dma_example.odt

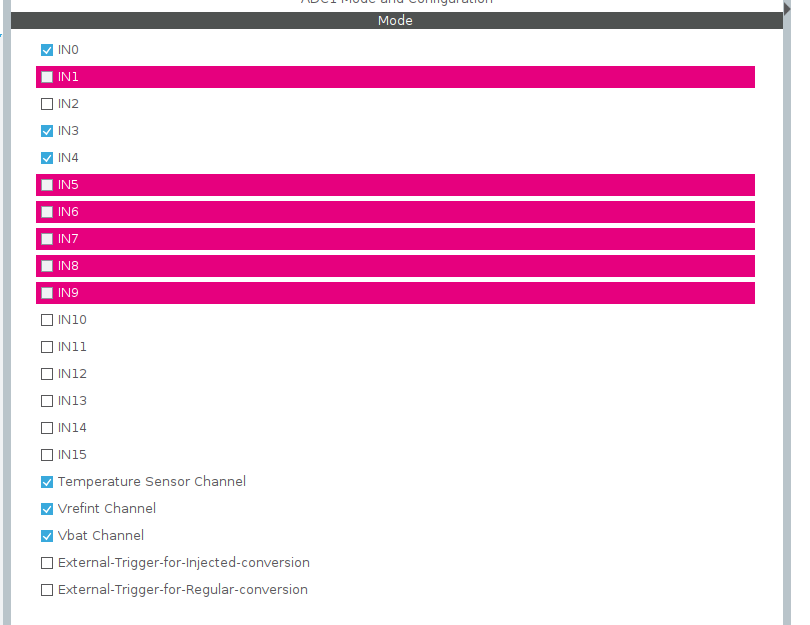
[picture p3: figure]
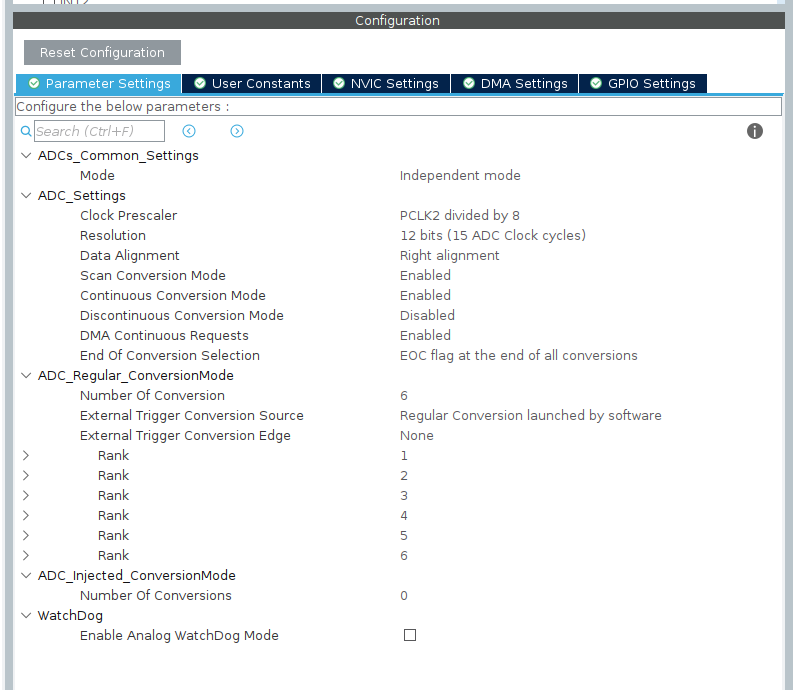
[picture p4: figure]
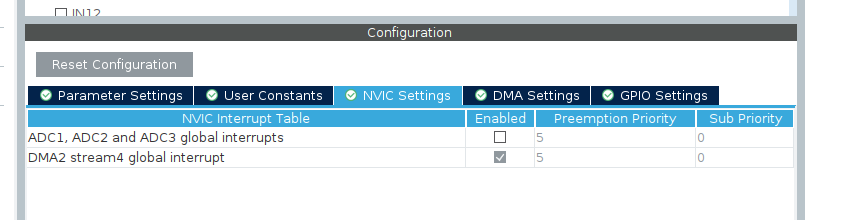
[picture p5: figure]
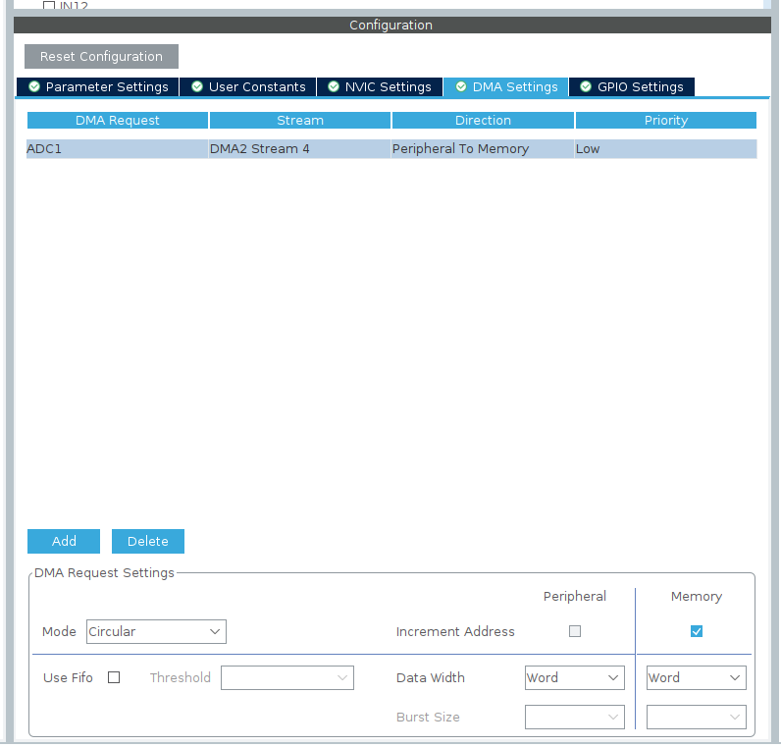
[picture p6: figure]
