katodo/pNav32_RobotMotorController/Hardware/RobotMotorController/pin_mapping.png

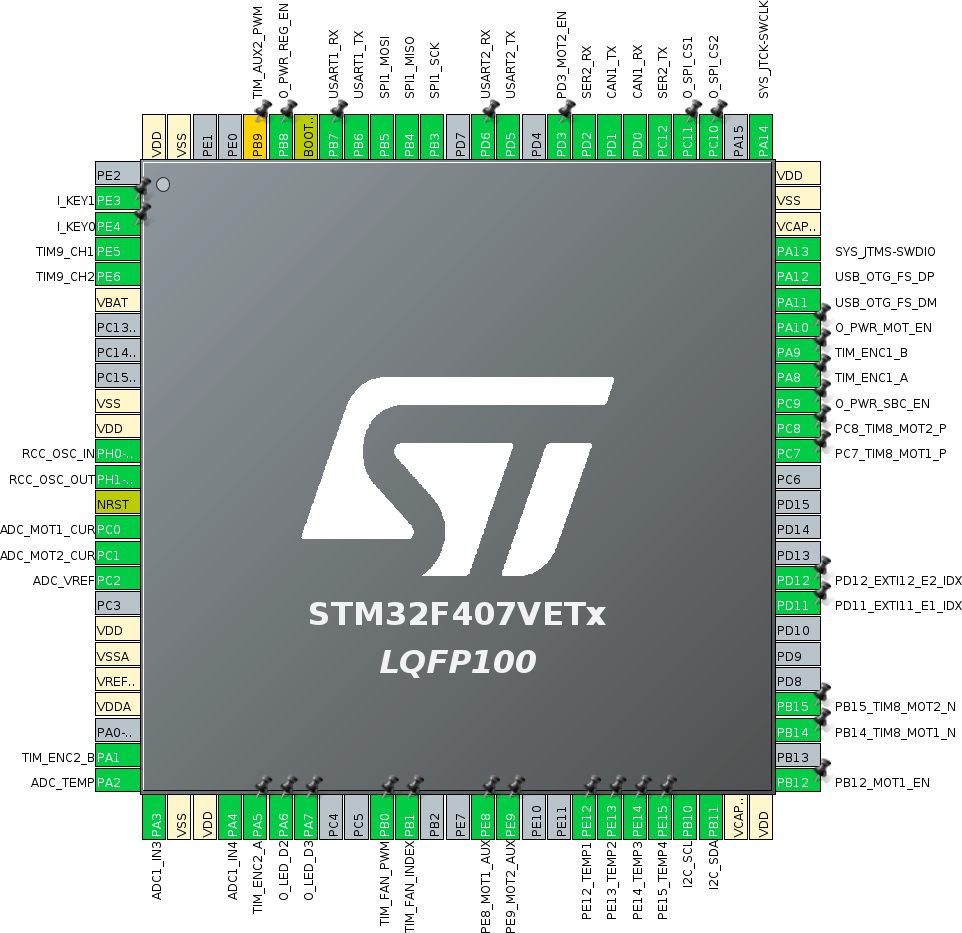
Hardware/RobotMotorController/pin_mapping.png
