katodo/pNav32_RobotMotorController/Hardware/RobotMotorController/Rendering/RobotMotorController_001.jpg

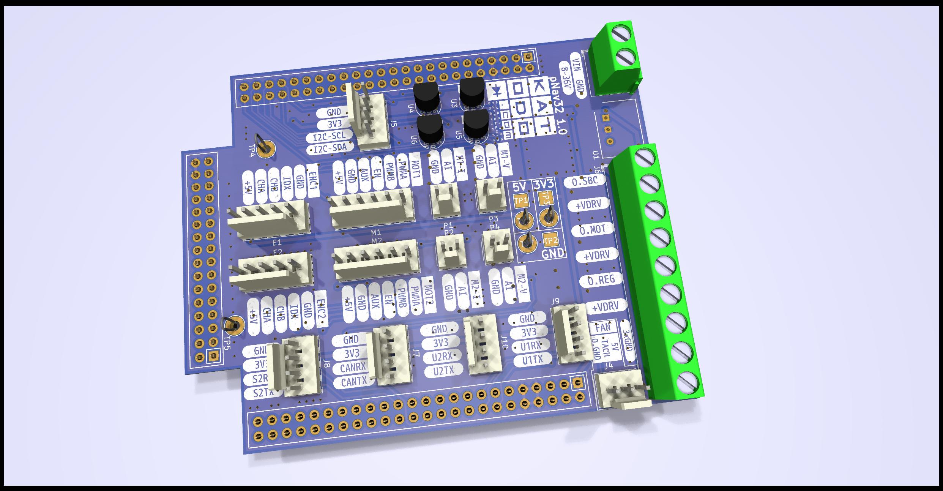
Hardware/RobotMotorController/Rendering/RobotMotorController_001.jpg
