katodo/pNav32_RobotMotorController/Hardware/RobotMotorController/Rendering/RobotMotorController_002.jpg

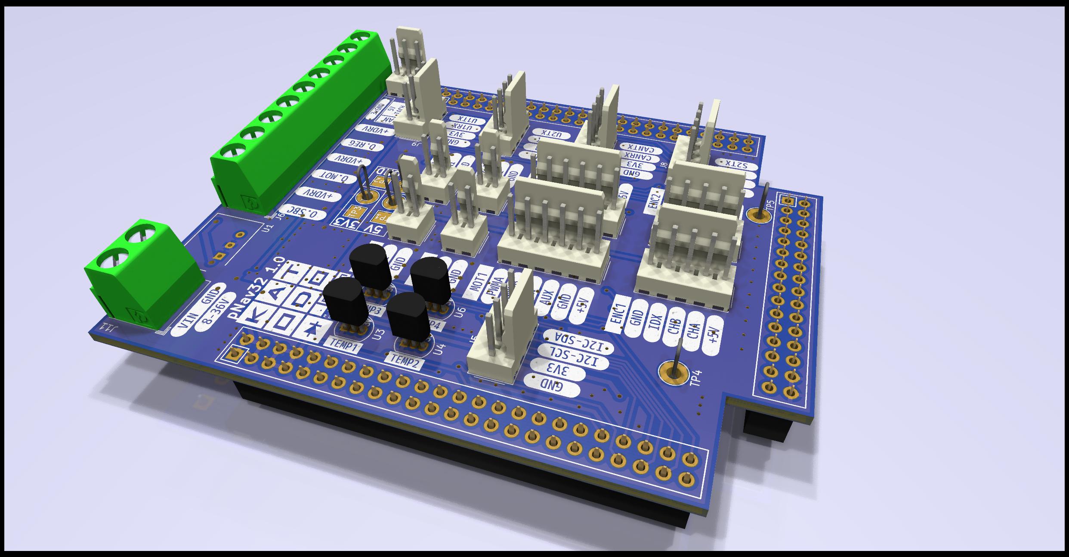
Hardware/RobotMotorController/Rendering/RobotMotorController_002.jpg
