katodo/pNav32_RobotMotorController/Hardware/RobotMotorController/Rendering/RobotMotorController_003.jpg

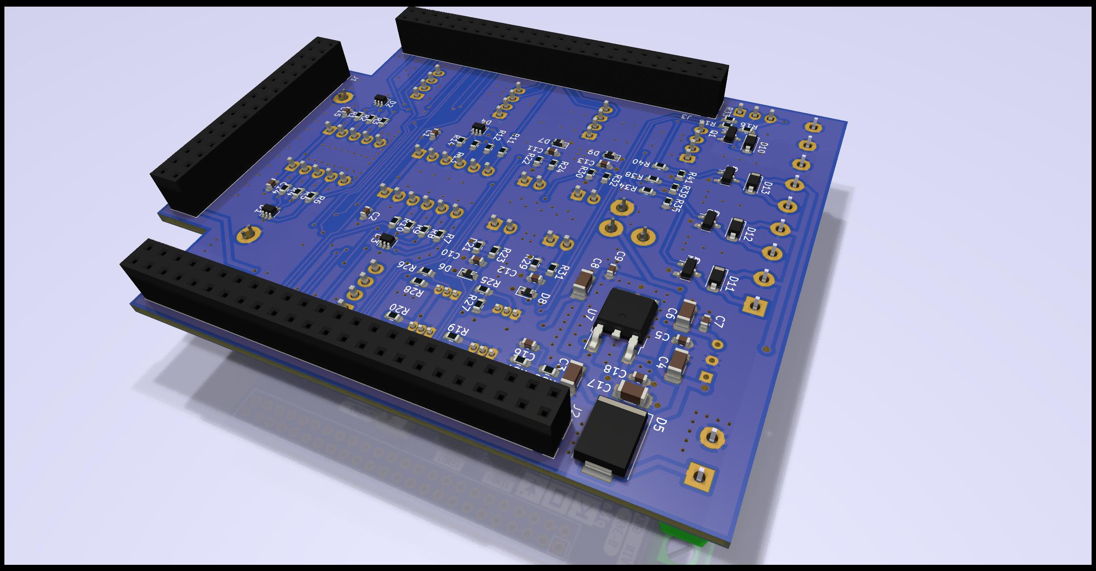
Hardware/RobotMotorController/Rendering/RobotMotorController_003.jpg
