katodo/pNav32_RobotMotorController/Hardware/RobotMotorController/Rendering/RobotMotorController_004.jpg

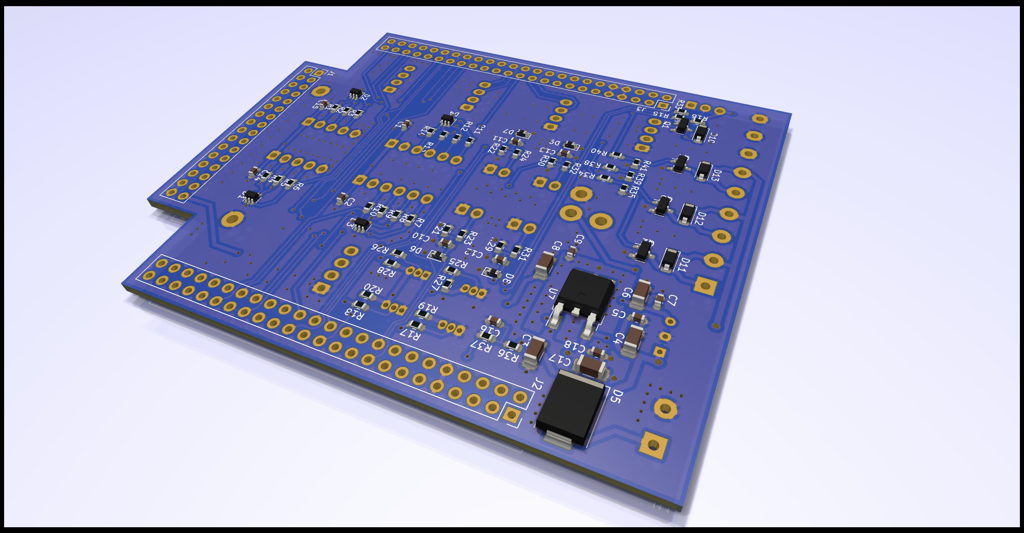
Hardware/RobotMotorController/Rendering/RobotMotorController_004.jpg
