katodo/pNav32_RobotMotorController/Hardware/RobotMotorController/Rendering/RobotMotorController_005.jpg

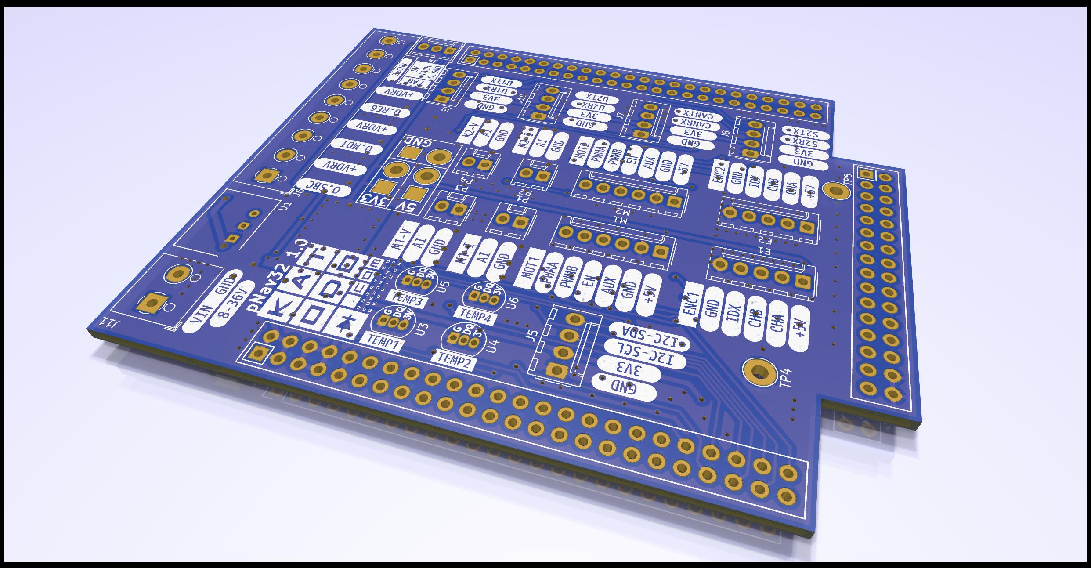
Hardware/RobotMotorController/Rendering/RobotMotorController_005.jpg
