katodo/pNav32_RobotMotorController/Hardware/RobotMotorController/Rendering/RobotMotorController_Resistor_to_be_added_by_Hand.jpg

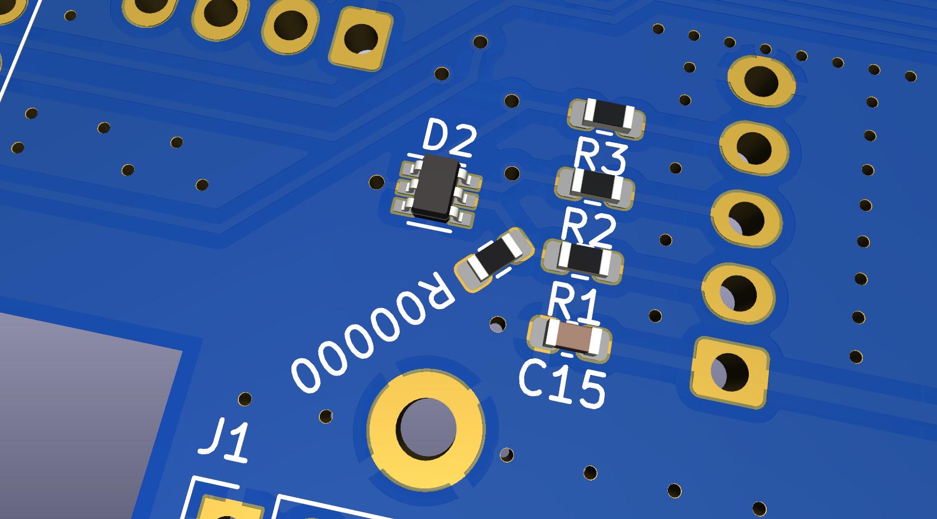
Hardware/RobotMotorController/Rendering/RobotMotorController_Resistor_to_be_added_by_Hand.jpg
