katodo/pNav32_RobotMotorController/Hardware/hBridge3620_Rev1/hBridge3620.pdf

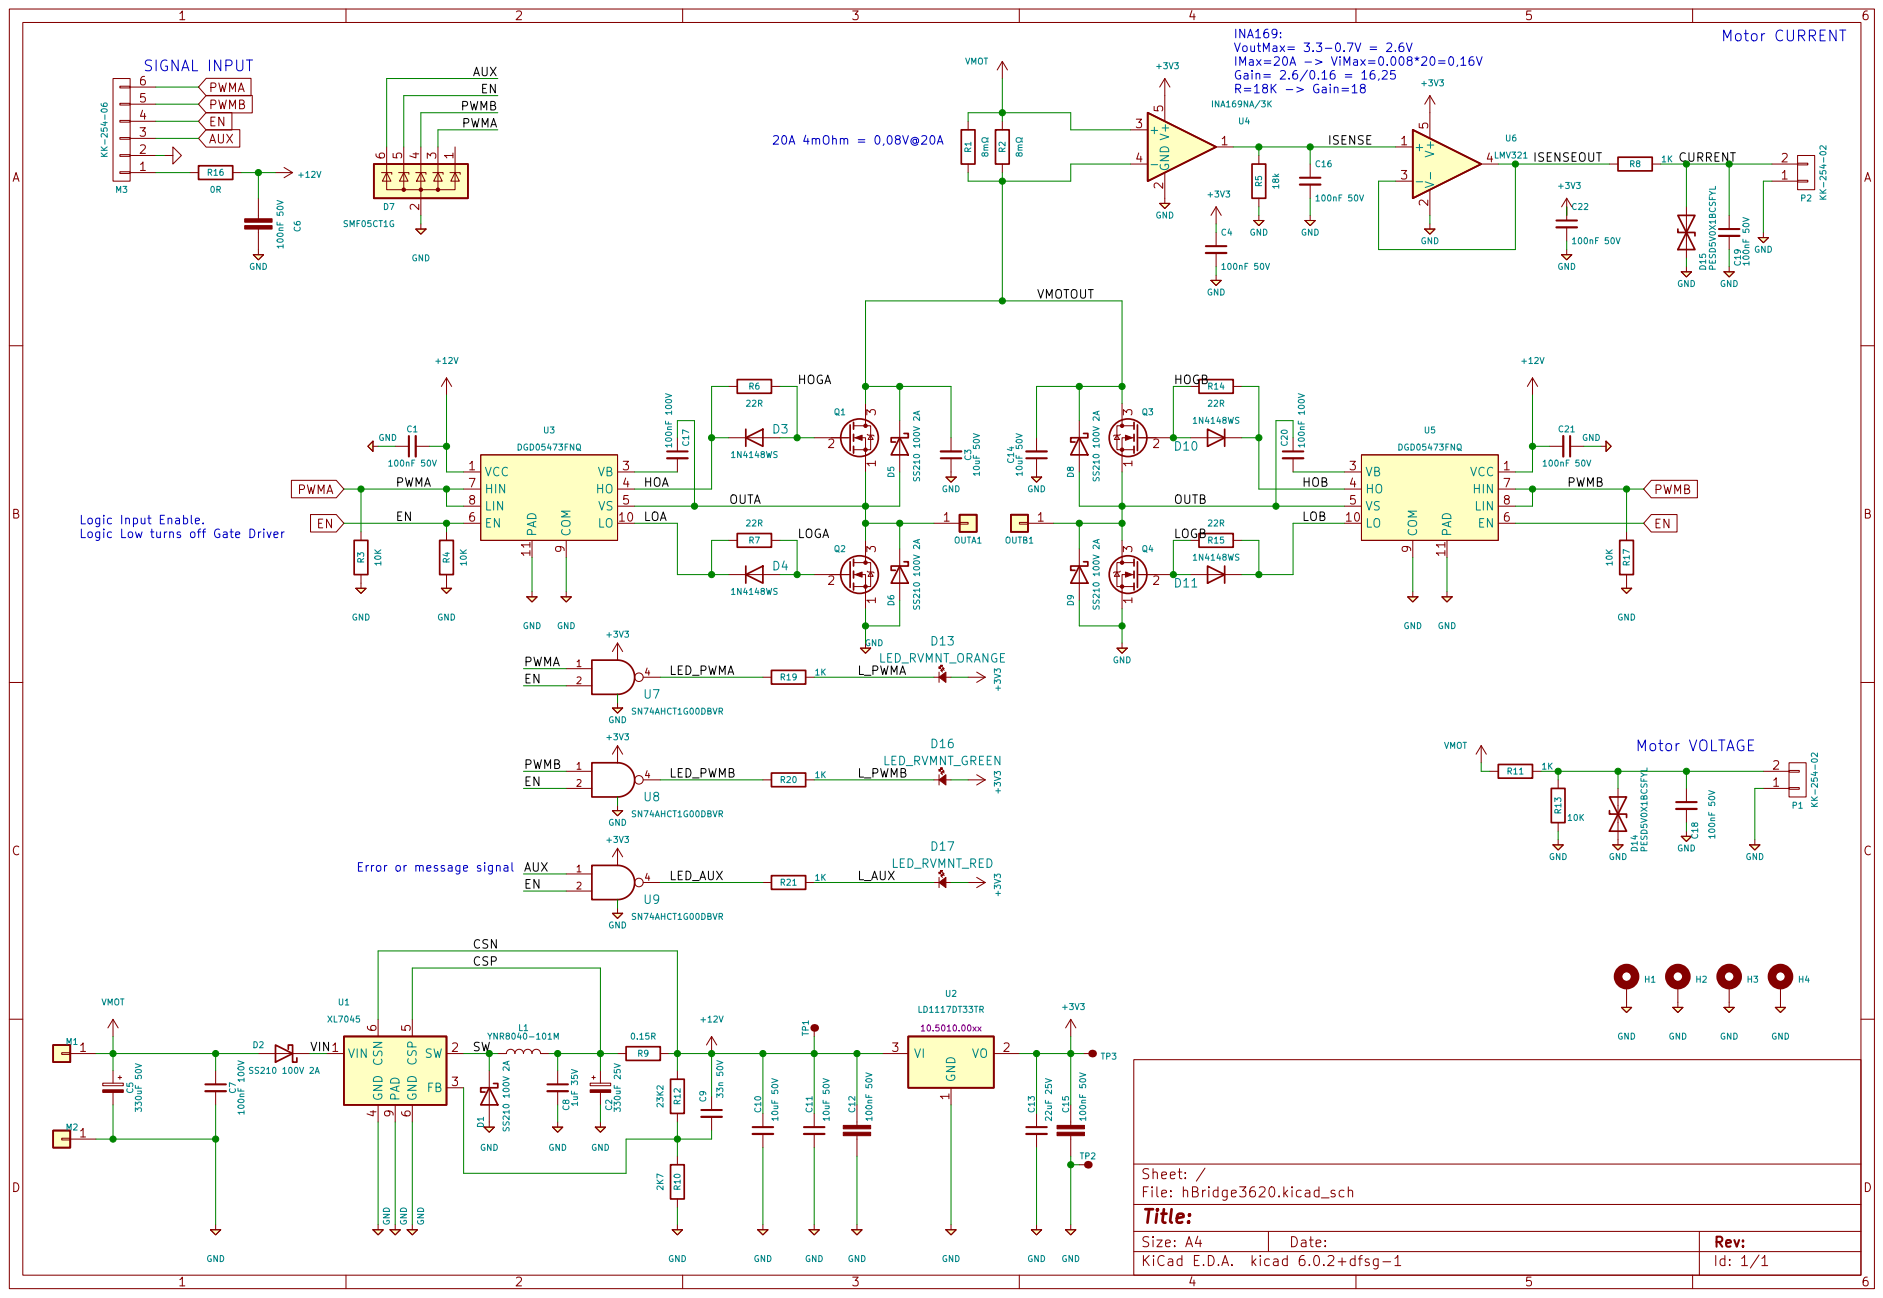
[picture p17: page 1]

IMax=20A -> ViMax=0.008*20=0,16V Gain= 2.6/0.16 = 16,25 R=18K -> Gain=18 Error or message signal

Logic Input Enable.
Logic Low turns off Gate Driver
