katodo/pNav32_RobotMotorController/Hardware/RobotMotorController/RobotMotorController.pdf

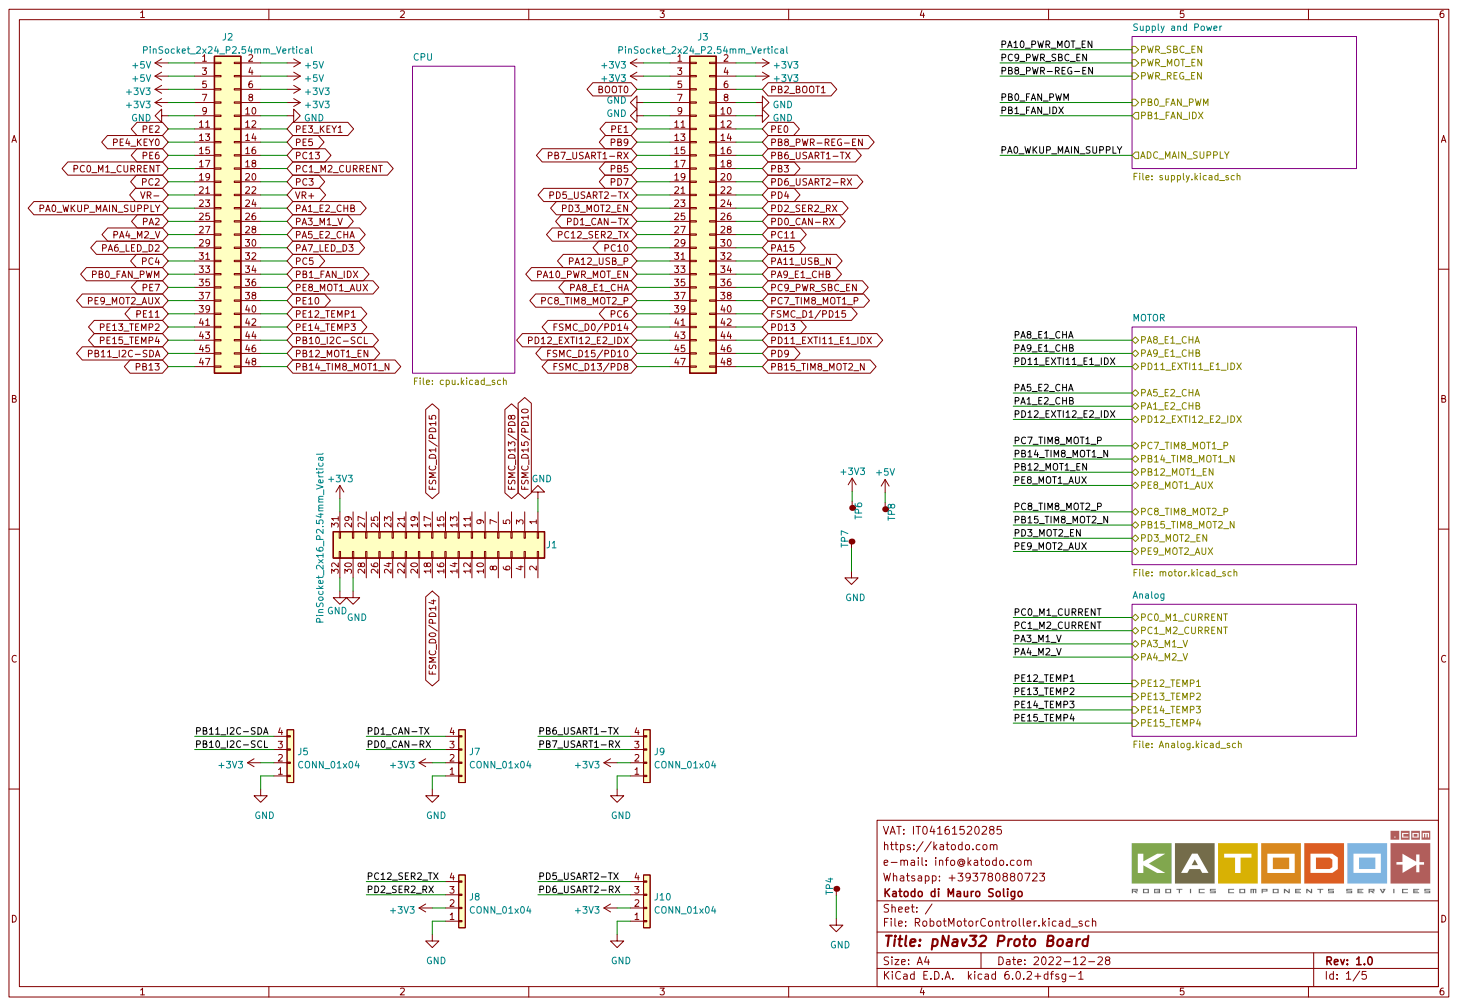
[picture p18: page 1]

https://katodo.com
e-mail: info@katodo.com
Whatsapp: +393780880723
File: RobotMotorController.kicad_sch Sheet: / Katodo di Mauro Soligo

Id: 1/5 Title: pNav32 Proto Board

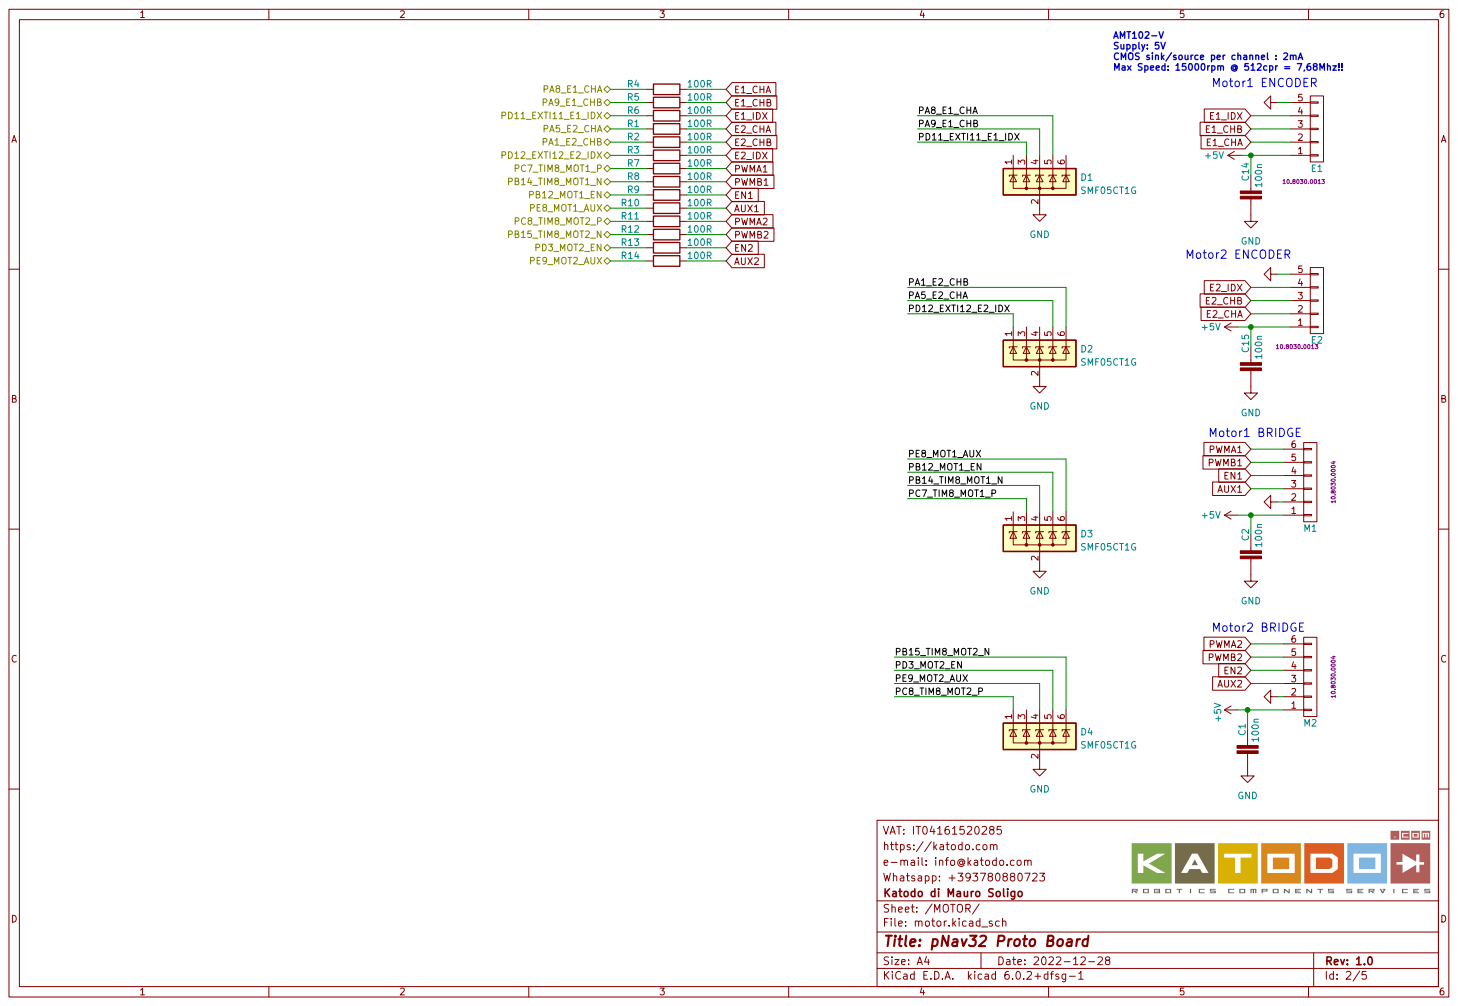
[picture p19: page 2]

AMT102-V
Supply: 5V
CMOS sink/source per channel : 2mA
Max Speed: 15000rpm @ 512cpr = 7,68Mhz!!

VAT: IT04161520285
https://katodo.com
e-mail: info@katodo.com
Whatsapp: +393780880723
File: motor.kicad_sch Sheet: /MOTOR/ Katodo di Mauro Soligo

Id: 2/5 Title: pNav32 Proto Board

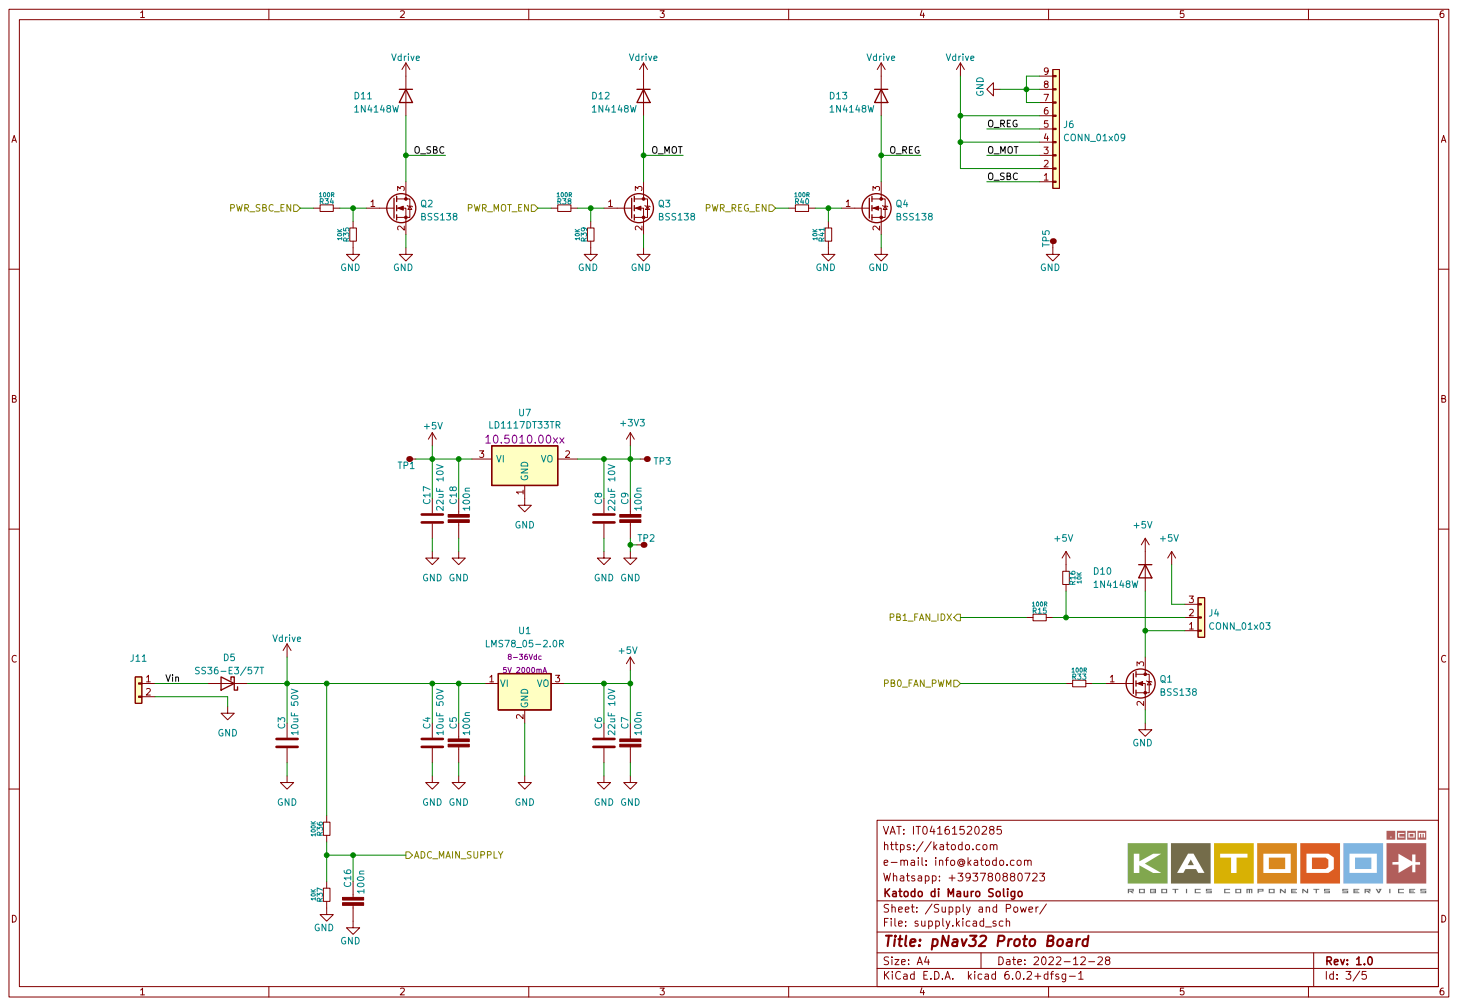
[picture p20: page 3]

VAT: IT04161520285 e-mail: info@katodo.com Whatsapp: +393780880723

Katodo di Mauro Soligo

Sheet: /Supply and Power/

File: supply.kicad_sch
Id: 3/5 Title: pNav32 Proto Board

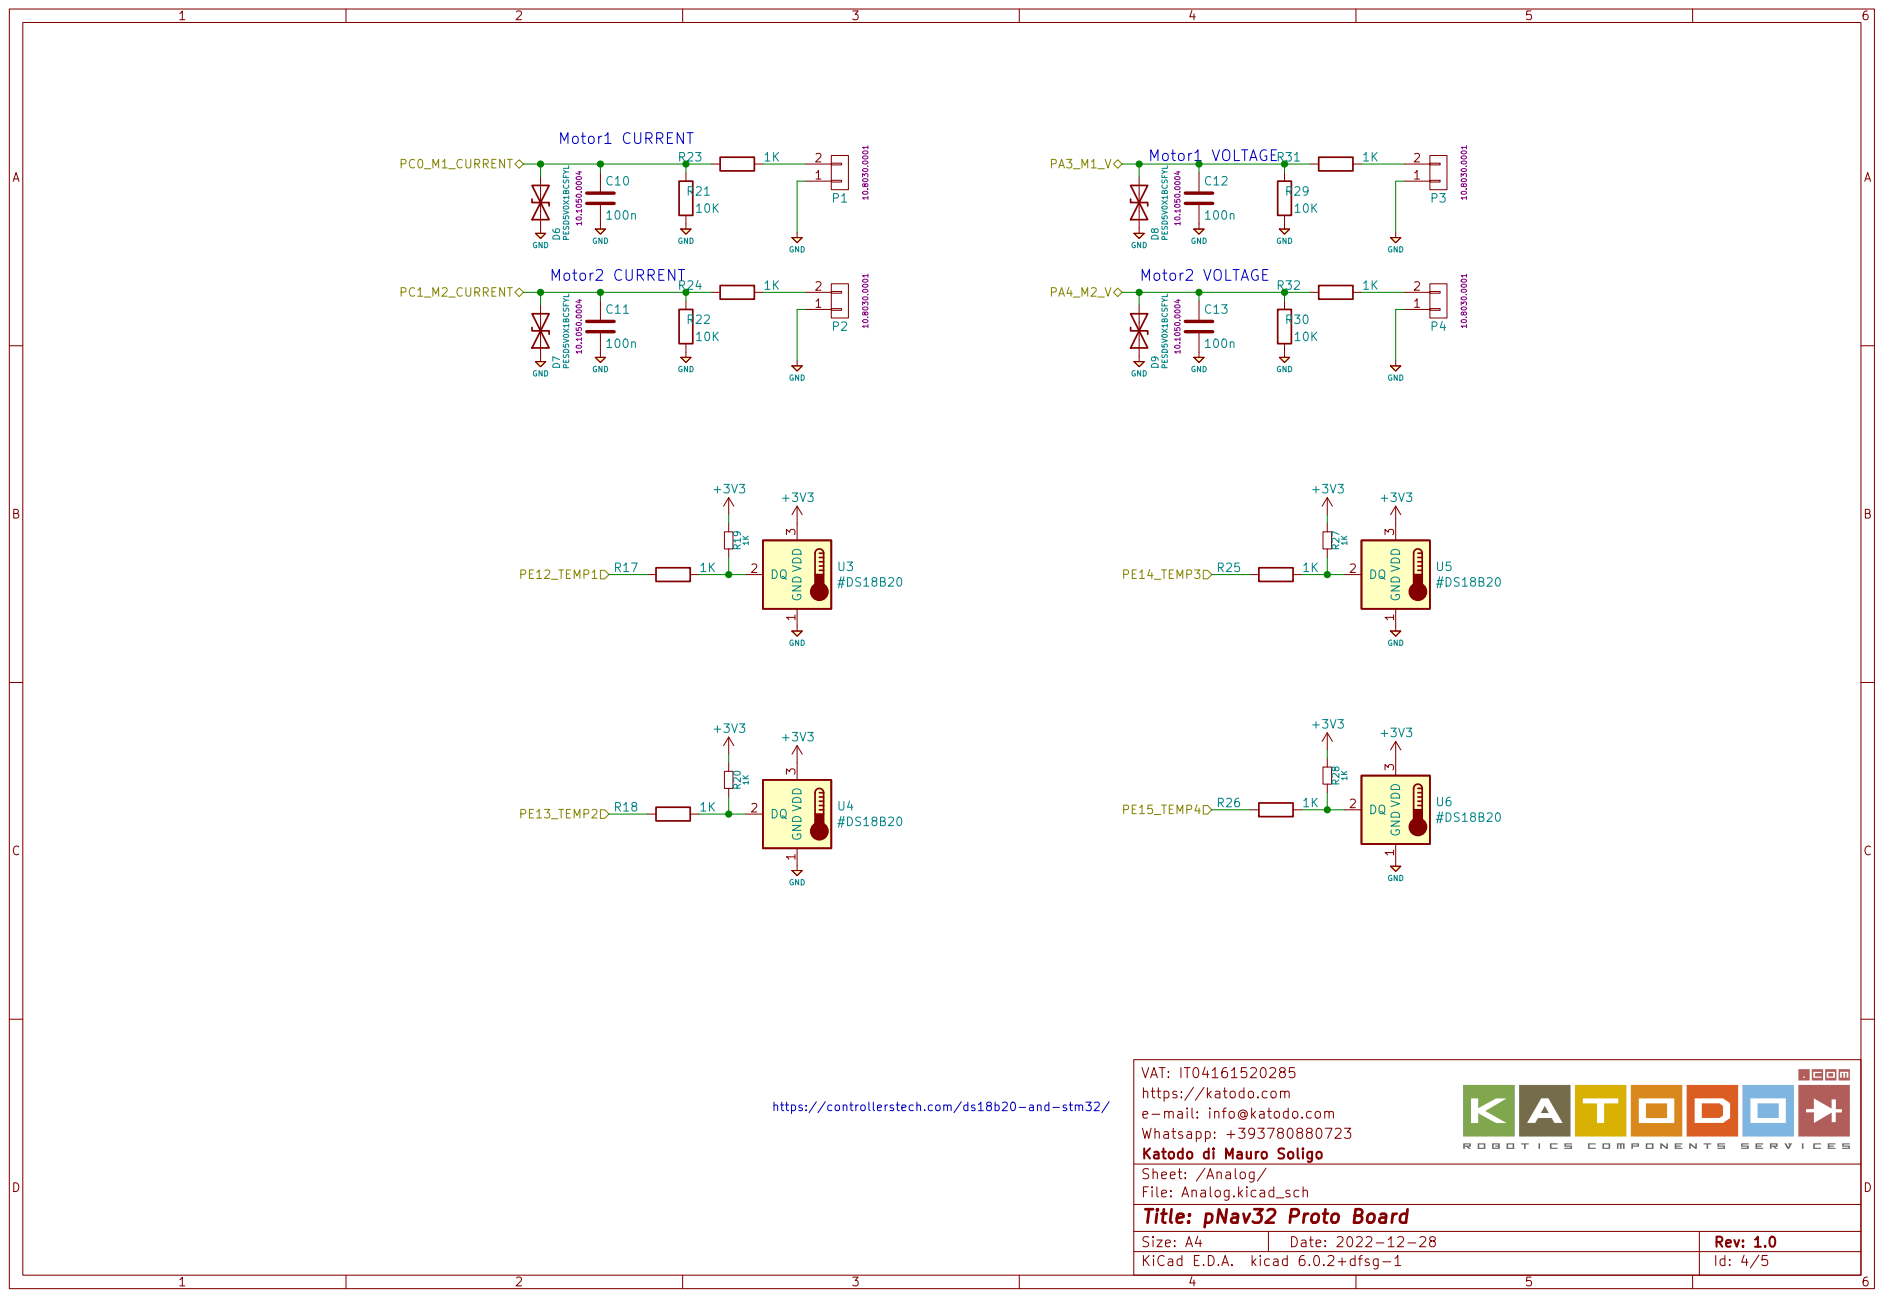
[picture p21: page 4]

VAT: IT04161520285
https://katodo.com
e-mail: info@katodo.com
Whatsapp: +393780880723
Katodo di Mauro Soligo
Sheet: /Analog/
File: Analog.kicad_sch
Id: 4/5 Title: pNav32 Proto Board

https://controllerstech.com/ds18b20-and-stm32/

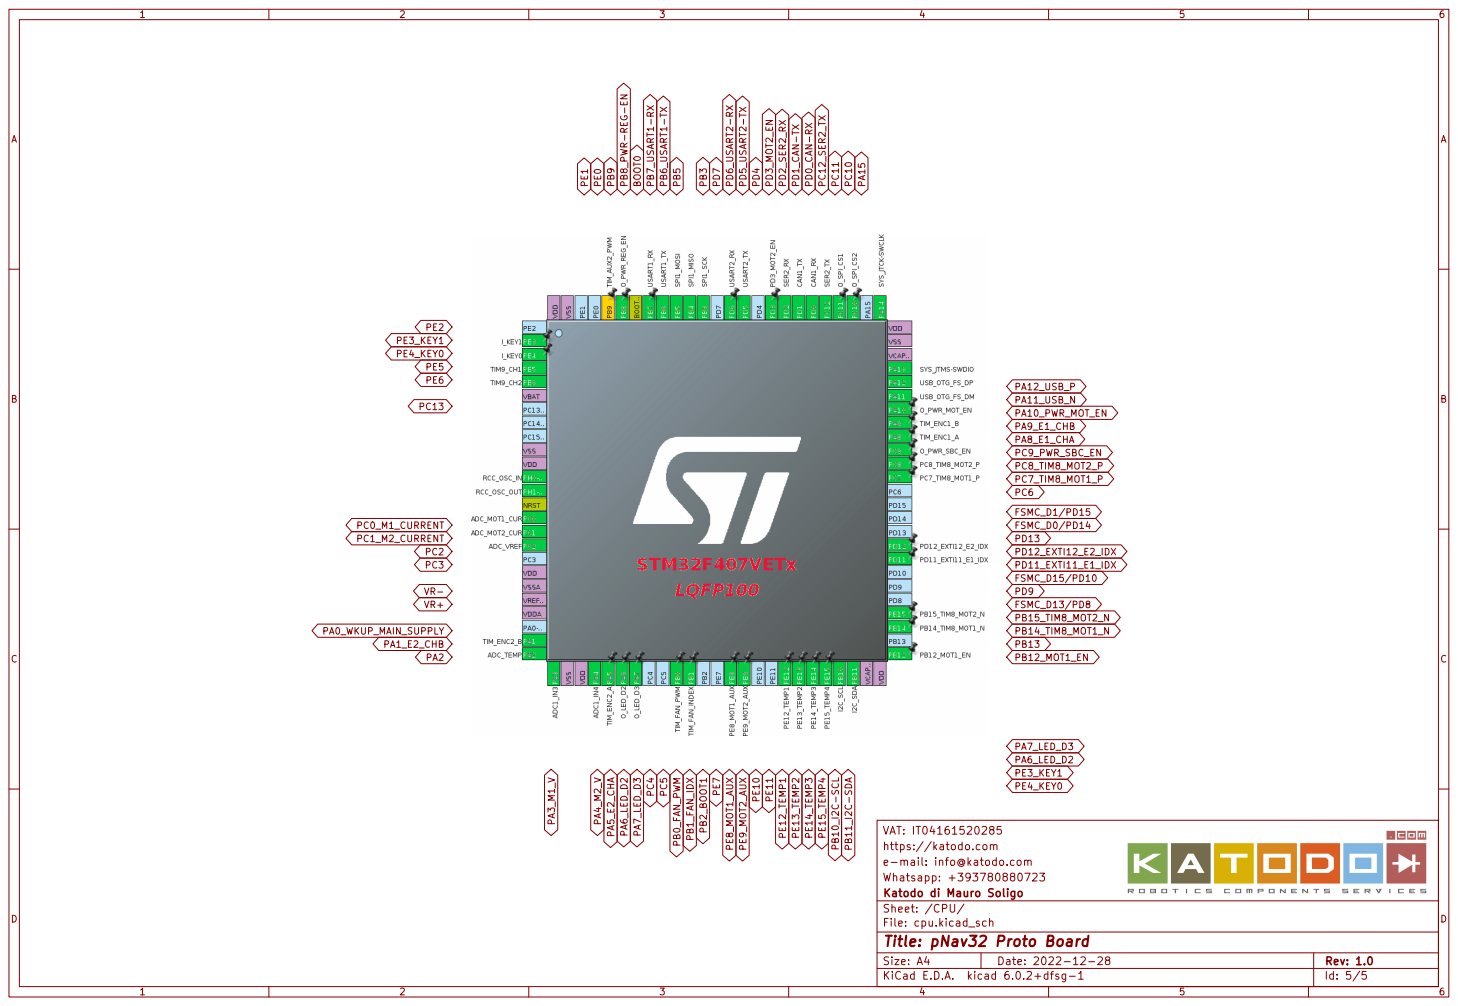
[picture p22: page 5]

https://katodo.com
e-mail: info@katodo.com
Whatsapp: +393780880723
File: cpu.kicad_sch Sheet: /CPU/ Katodo di Mauro Soligo

Id: 5/5 Title: pNav32 Proto Board
