katodo/pNav32_RobotMotorController/(list of files, drawings)

Other design files:
Hardware/RobotMotorController/freerouting.dsn
