katodo/pNav32_RobotMotorController/Hardware/RobotMotorController/RobotMotorController.kicad_pcb

## KiCad design Hardware/RobotMotorController/RobotMotorController.kicad_pcb (2025-01-12)

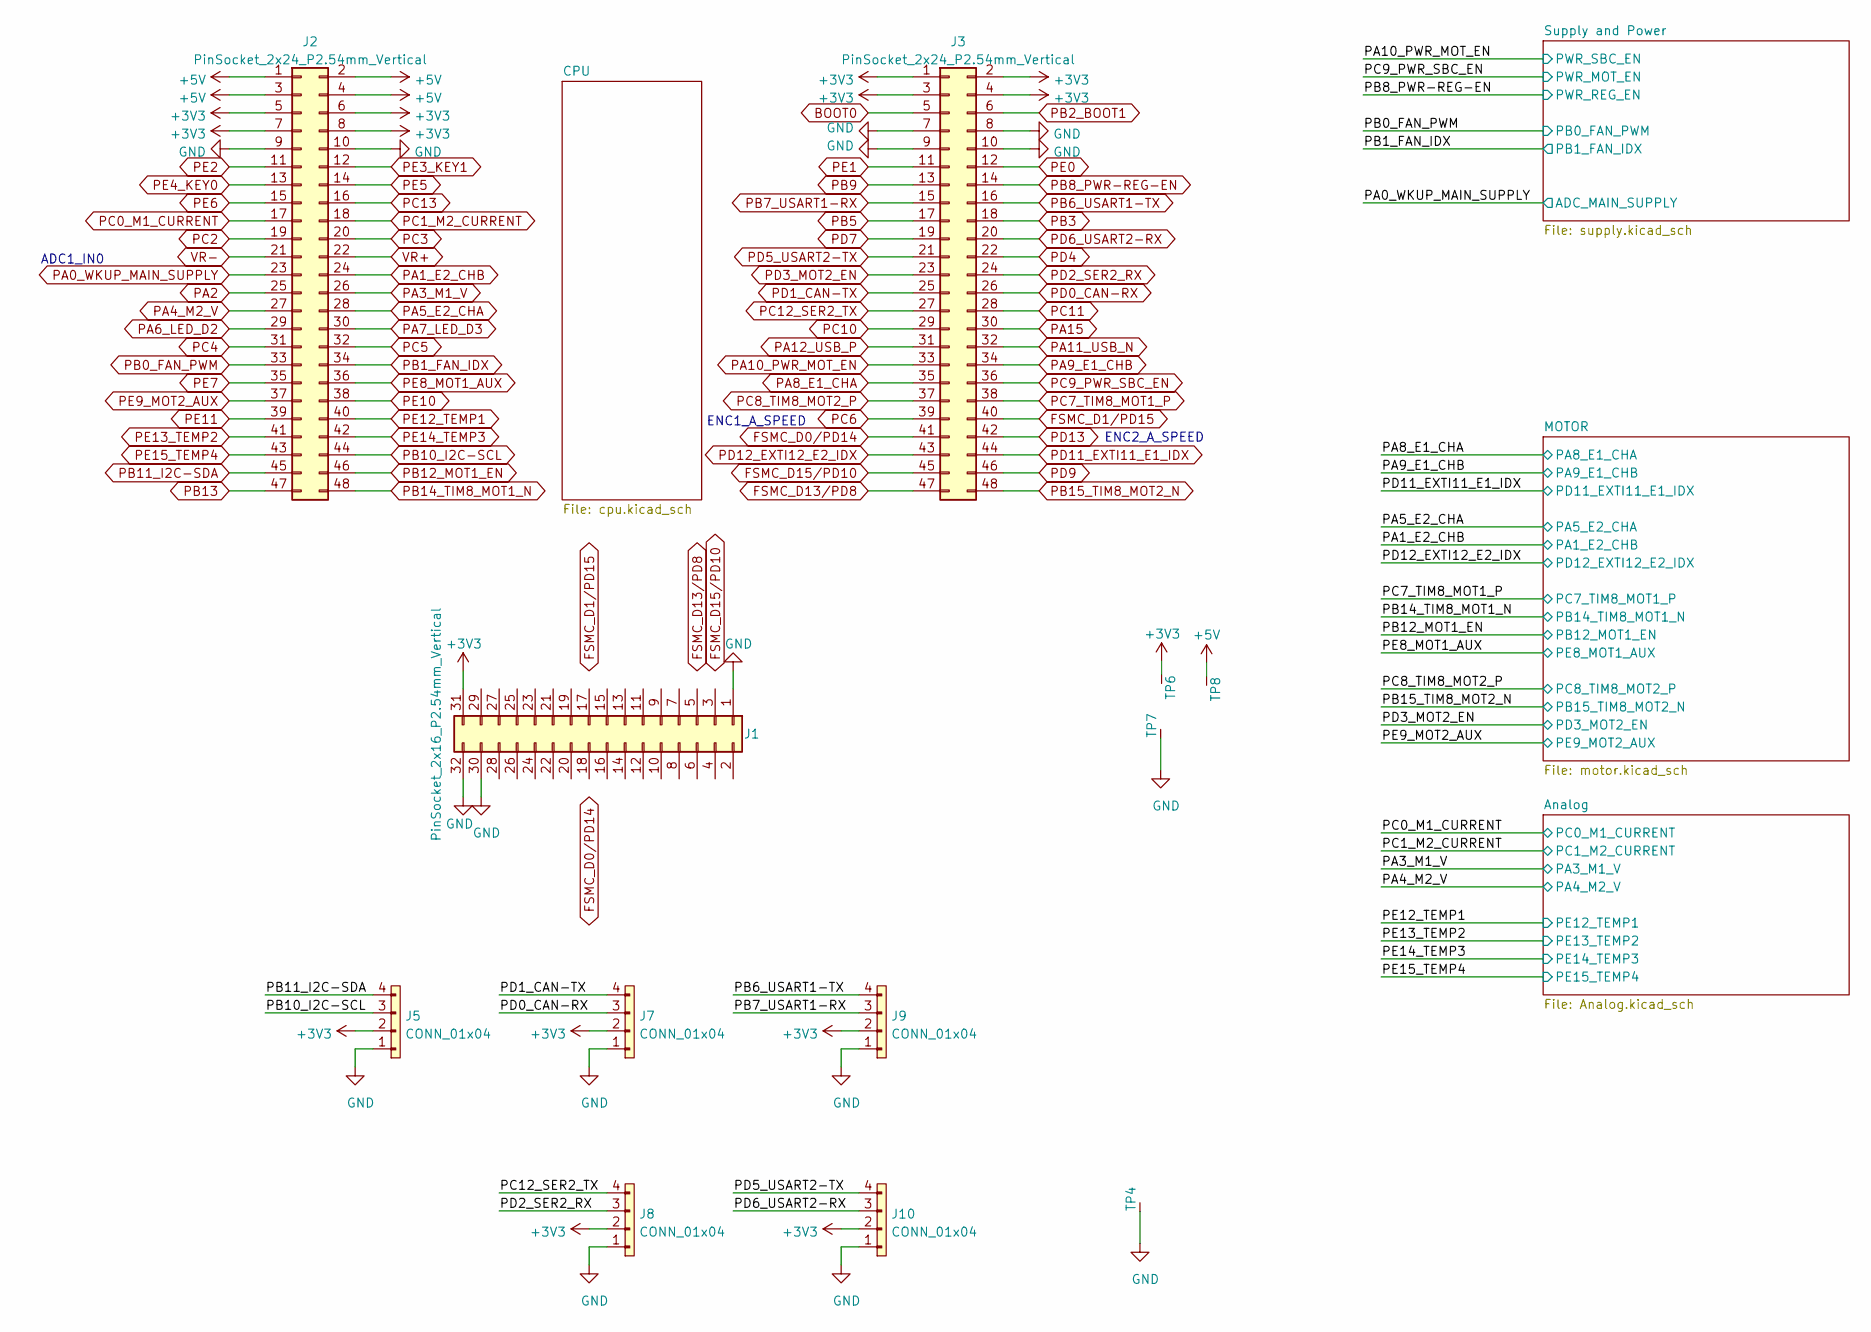
[picture p25: schematic RobotMotorController.kicad_sch, pNav32 Proto Board]

Parts:
J1: PinSocket_2x16_P2.54mm_Vertical
J2, J3: PinSocket_2x24_P2.54mm_Vertical
J5, J7, J8, J9, J10: CONN_01x04; Molex_KK-254_AE-6410-04A_1x04_P2.54mm_Vertical
TP4, TP6, TP7, TP8: TESTPAD; TestPoint_Loop_D2.50mm_Drill1.85mm

Connections:
+3V3: J1.31, J2.5, J2.6, J2.7, J2.8, J3.1, J3.2, J3.3, J3.4, J5.2, J7.2, J8.2, J9.2, J10.2, TP6.1 (TP); also elsewhere on the board
+5V: J2.1, J2.2, J2.3, J2.4, TP8.1 (TP); also elsewhere on the board
BOOT0: J3.5
FSMC_D0/PD14: J3.41
FSMC_D1/PD15: J3.40
FSMC_D13/PD8: J3.47
FSMC_D15/PD10: J3.45
GND: J1.1, J1.30, J1.32, J2.9, J2.10, J3.7, J3.8, J3.9, J3.10, J5.1, J7.1, J8.1, J9.1, J10.1, TP4.1 (TP), TP7.1 (TP); also elsewhere on the board
PA0_WKUP_MAIN_SUPPLY: J2.23; also elsewhere on the board
PA1_E2_CHB: J2.24; also elsewhere on the board
PA2: J2.25
PA3_M1_V: J2.26; also elsewhere on the board
PA4_M2_V: J2.27; also elsewhere on the board
PA5_E2_CHA: J2.28; also elsewhere on the board
PA6_LED_D2: J2.29
PA7_LED_D3: J2.30
PA8_E1_CHA: J3.35; also elsewhere on the board
PA9_E1_CHB: J3.34; also elsewhere on the board
PA10_PWR_MOT_EN: J3.33; also elsewhere on the board
PA11_USB_N: J3.32
PA12_USB_P: J3.31
PA15: J3.30
PB0_FAN_PWM: J2.33; also elsewhere on the board
PB1_FAN_IDX: J2.34; also elsewhere on the board
PB2_BOOT1: J3.6
PB3: J3.18
PB5: J3.17
PB6_USART1-TX: J3.16, J9.4
PB7_USART1-RX: J3.15, J9.3
PB8_PWR-REG-EN: J3.14; also elsewhere on the board
PB9: J3.13
PB10_I2C-SCL: J2.44, J5.3
PB11_I2C-SDA: J2.45, J5.4
PB12_MOT1_EN: J2.46; also elsewhere on the board
PB13: J2.47
PB14_TIM8_MOT1_N: J2.48; also elsewhere on the board
PB15_TIM8_MOT2_N: J3.48; also elsewhere on the board
PC0_M1_CURRENT: J2.17; also elsewhere on the board
PC1_M2_CURRENT: J2.18; also elsewhere on the board
PC2: J2.19
PC3: J2.20
PC4: J2.31
PC5: J2.32
PC6: J3.39
PC7_TIM8_MOT1_P: J3.38; also elsewhere on the board
PC8_TIM8_MOT2_P: J3.37; also elsewhere on the board
PC9_PWR_SBC_EN: J3.36; also elsewhere on the board
PC10: J3.29
PC11: J3.28
PC12_SER2_TX: J3.27, J8.4
PC13: J2.16
PD0_CAN-RX: J3.26, J7.3
PD1_CAN-TX: J3.25, J7.4
PD2_SER2_RX: J3.24, J8.3
PD3_MOT2_EN: J3.23; also elsewhere on the board
PD4: J3.22
PD5_USART2-TX: J3.21, J10.4
PD6_USART2-RX: J3.20, J10.3
PD7: J3.19
PD9: J3.46
PD11_EXTI11_E1_IDX: J3.44; also elsewhere on the board
PD12_EXTI12_E2_IDX: J3.43; also elsewhere on the board
PD13: J3.42
PE0: J3.12
PE1: J3.11
PE2: J2.11
PE3_KEY1: J2.12
PE4_KEY0: J2.13
PE5: J2.14
PE6: J2.15
PE7: J2.35
PE8_MOT1_AUX: J2.36; also elsewhere on the board
PE9_MOT2_AUX: J2.37; also elsewhere on the board
PE10: J2.38
PE11: J2.39
PE12_TEMP1: J2.40; also elsewhere on the board
PE13_TEMP2: J2.41; also elsewhere on the board
PE14_TEMP3: J2.42; also elsewhere on the board
PE15_TEMP4: J2.43; also elsewhere on the board
VR+: J2.22
VR-: J2.21

Notes on the sheet:
ENC2_A_SPEED
ENC1_A_SPEED
ADC1_IN0

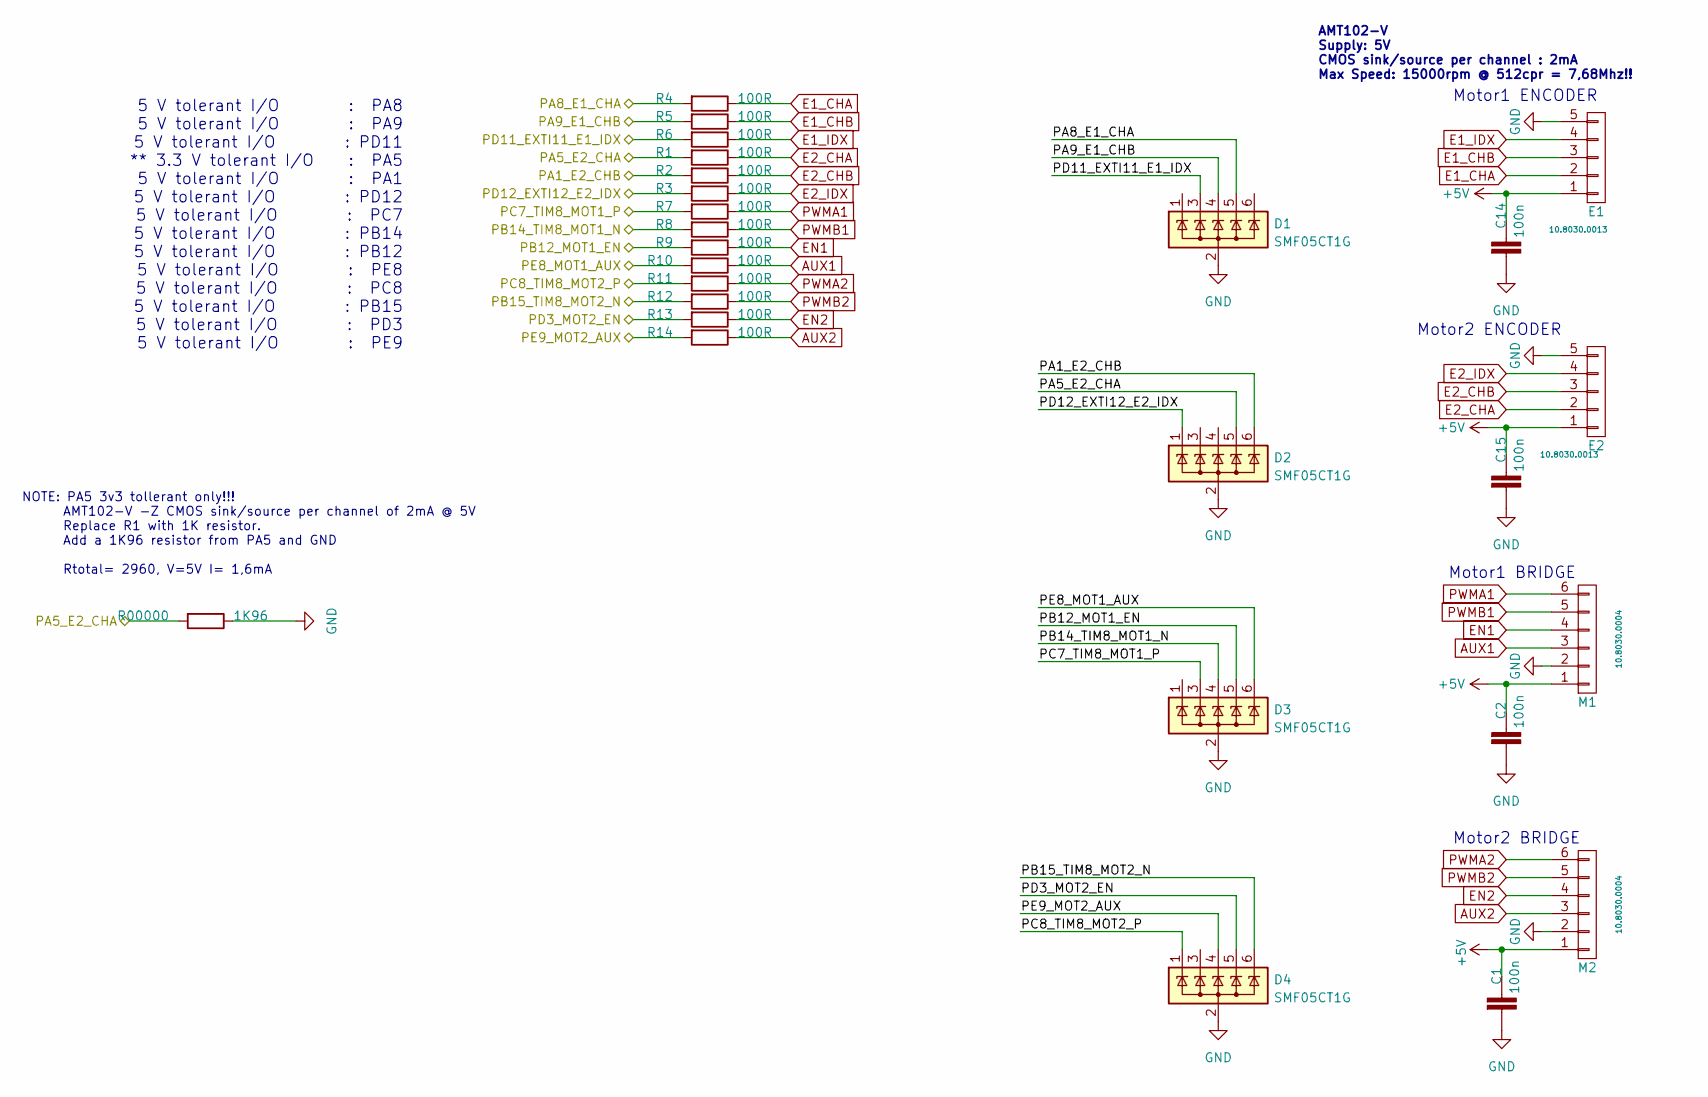
[picture p26: schematic motor.kicad_sch, pNav32 Proto Board]

Parts:
C1, C2, C14, C15: 100n; C_0603_1608Metric; LCSC C14663
D1, D2, D3, D4: SMF05CT1G; SOT-363_SC-70-6; LCSC C15879
E1, E2: Molex_KK-254_AE-6410-05A_1x05_P2.54mm_Vertical
M1, M2: Molex_KK-254_AE-6410-06A_1x06_P2.54mm_Vertical
R00000: 1K96; R_0603_1608Metric; LCSC C227664
R1: 100R; R_0603_1608Metric; LCSC C21190
R2, R3, R4, R5, R6, R7, R8, R9, R10, R11, R12, R13, R14: 100R; R_0603_1608Metric; LCSC C22775

Connections:
+5V: C1.1, C2.1, C14.1, C15.1, E1.1, E2.1, M1.1, M2.1; also elsewhere on the board
AUX1: M1.3, R10.1
AUX2: M2.3, R14.1
E1_CHA: E1.2, R4.1
E1_CHB: E1.3, R5.1
E1_IDX: E1.4, R6.1
E2_CHA: E2.2, R1.1
E2_CHB: E2.3, R2.1
E2_IDX: E2.4, R3.1
EN1: M1.4, R9.1
EN2: M2.4, R13.1
GND: C1.2, C2.2, C14.2, C15.2, D1.2 (A), D2.2 (A), D3.2 (A), D4.2 (A), E1.5, E2.5, M1.2, M2.2, R00000.1; also elsewhere on the board
PA1_E2_CHB: D2.6 (K), R2.2; also elsewhere on the board
PA5_E2_CHA: D2.5 (K), R00000.2, R1.2; also elsewhere on the board
PA8_E1_CHA: D1.5 (K), R4.2; also elsewhere on the board
PA9_E1_CHB: D1.4 (K), R5.2; also elsewhere on the board
PB12_MOT1_EN: D3.5 (K), R9.2; also elsewhere on the board
PB14_TIM8_MOT1_N: D3.4 (K), R8.2; also elsewhere on the board
PB15_TIM8_MOT2_N: D4.6 (K), R12.2; also elsewhere on the board
PC7_TIM8_MOT1_P: D3.3 (K), R7.2; also elsewhere on the board
PC8_TIM8_MOT2_P: D4.1 (K), R11.2; also elsewhere on the board
PD3_MOT2_EN: D4.5 (K), R13.2; also elsewhere on the board
PD11_EXTI11_E1_IDX: D1.3 (K), R6.2; also elsewhere on the board
PD12_EXTI12_E2_IDX: D2.1 (K), R3.2; also elsewhere on the board
PE8_MOT1_AUX: D3.6 (K), R10.2; also elsewhere on the board
PE9_MOT2_AUX: D4.4 (K), R14.2; also elsewhere on the board
PWMA1: M1.6, R7.1
PWMA2: M2.6, R11.1
PWMB1: M1.5, R8.1
PWMB2: M2.5, R12.1

Notes on the sheet:
Motor1 ENCODER
Motor2 ENCODER
Motor2 BRIDGE
5 V tolerant I/O : PA8 5 V tolerant I/O : PA9 5 V tolerant I/O : PD11 ** 3.3 V tolerant I/O : PA5 5 V tolerant I/O : PA1 5 V tolerant I/O : PD12 5 V tolerant I/O : PC7 5 V tolerant I/O : PB14 5 V tolerant I/O : PB12 5 V tolerant I/O : PE8 5 V tolerant I/O : PC8 5 V tolerant I/O : PB15 5 V tolerant 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
NOTE: PA5 3v3 tollerant only!!! AMT102-V -Z CMOS sink/source per channel of 2mA @ 5V Replace R1 with 1K resistor. Add a 1K96 resistor from PA5 and GND Rtotal= 2960, V=5V I= 1,6mA
Motor1 BRIDGE
AMT102-V Supply: 5V CMOS sink/source per channel : 2mA Max Speed: 15000rpm @ 512cpr = 7,68Mhz!!

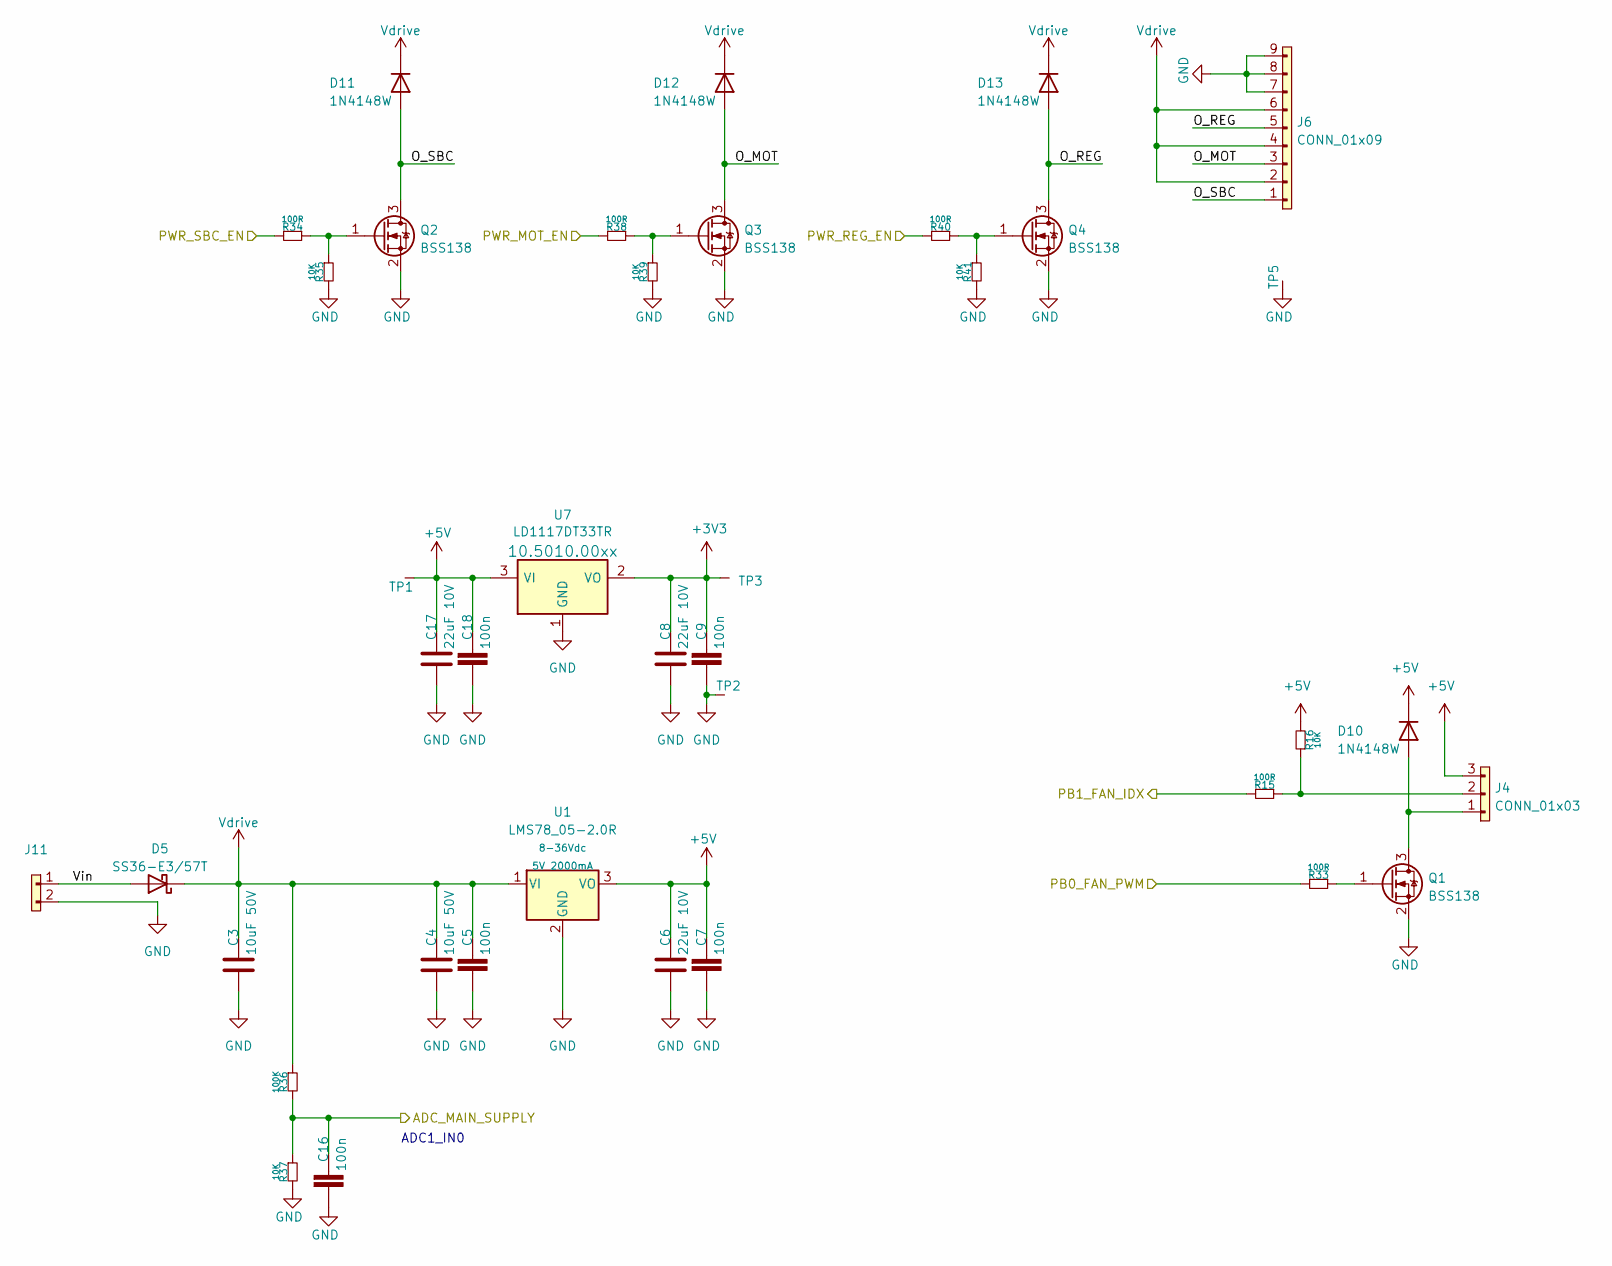
[picture p27: schematic supply.kicad_sch, pNav32 Proto Board]

Parts:
C3, C4: 10uF 50V; C_1206_3216Metric_Pad1.33x1.80mm_HandSolder; DIGIKEY 1276-6736-1-ND
C5, C7, C9, C16, C18: 100n; C_0603_1608Metric; LCSC C14663
C6, C8, C17: 22uF 10V; C_1206_3216Metric_Pad1.33x1.80mm_HandSolder; LCSC C12891
D5: SS36-E3/57T; D_SMC; LCSC C35722
D10, D11, D12, D13: 1N4148W; D_SOD-123; LCSC C81598
J4: CONN_01x03; Molex_KK-254_AE-6410-03A_1x03_P2.54mm_Vertical
J6: CONN_01x09; DG300-5.0-09P-13
J11: dG300-5.0-02P-13-00AH; DG300-5.0-02P-13
Q1, Q2, Q3, Q4: BSS138; SOT-23; LCSC C255592
R15, R33, R34, R38, R40: 100R; R_0603_1608Metric; MPN CRCW06031K00FKEA; FARNELL 2122366
R16, R35, R37, R39, R41: 10K; R_0603_1608Metric; MPN CRCW06031K00FKEA; FARNELL 2122366
R36: 100K; R_0603_1608Metric; MPN CRCW06031K00FKEA; FARNELL 2122366
TP1, TP2, TP3: TESTPAD; TestPoint_Pad_2.5x2.5mm
TP5: TESTPAD; TestPoint_Loop_D2.50mm_Drill1.85mm
U1: LMS78_05-2.0R; SIP3_11.6x8.5mm; LCSC C2931187
U7: LD1117DT33TR; TO-252-2; LCSC C132629

Connections:
+3V3: C8.1, C9.1, TP3.1 (TP), U7.2 (VO); also elsewhere on the board
+5V: C6.1, C7.1, C17.1, C18.1, D10.1 (K), J4.3, R16.2, TP1.1 (TP), U1.3 (VO), U7.3 (VI); also elsewhere on the board
/Supply and Power/O_MOT: D12.2 (A), J6.3, Q3.3 (D)
/Supply and Power/O_REG: D13.2 (A), J6.5, Q4.3 (D)
/Supply and Power/O_SBC: D11.2 (A), J6.1, Q2.3 (D)
/Supply and Power/Vin: D5.2 (A), J11.1
GND: C3.2, C4.2, C5.2, C6.2, C7.2, C8.2, C9.2, C16.2, C17.2, C18.2, J6.7, J6.8, J6.9, J11.2, Q1.2 (S), Q2.2 (S), Q3.2 (S), Q4.2 (S), R35.2, R37.2, R39.2, R41.2, TP2.1 (TP), TP5.1 (TP), U1.2 (GND), U7.1 (GND); also elsewhere on the board
unnamed: D10.2 (A), J4.1, Q1.3 (D)
unnamed: J4.2, R15.1, R16.1
unnamed: Q1.1 (G), R33.1
unnamed: Q2.1 (G), R34.1, R35.1
unnamed: Q3.1 (G), R38.1, R39.1
unnamed: Q4.1 (G), R40.1, R41.1
PA0_WKUP_MAIN_SUPPLY: C16.1, R36.2, R37.1; also elsewhere on the board
PA10_PWR_MOT_EN: R34.2; also elsewhere on the board
PB0_FAN_PWM: R33.2; also elsewhere on the board
PB1_FAN_IDX: R15.2; also elsewhere on the board
PB8_PWR-REG-EN: R40.2; also elsewhere on the board
PC9_PWR_SBC_EN: R38.2; also elsewhere on the board
Vdrive: C3.1, C4.1, C5.1, D5.1 (K), D11.1 (K), D12.1 (K), D13.1 (K), J6.2, J6.4, J6.6, R36.1, U1.1 (VI)

Notes on the sheet:
ADC1_IN0

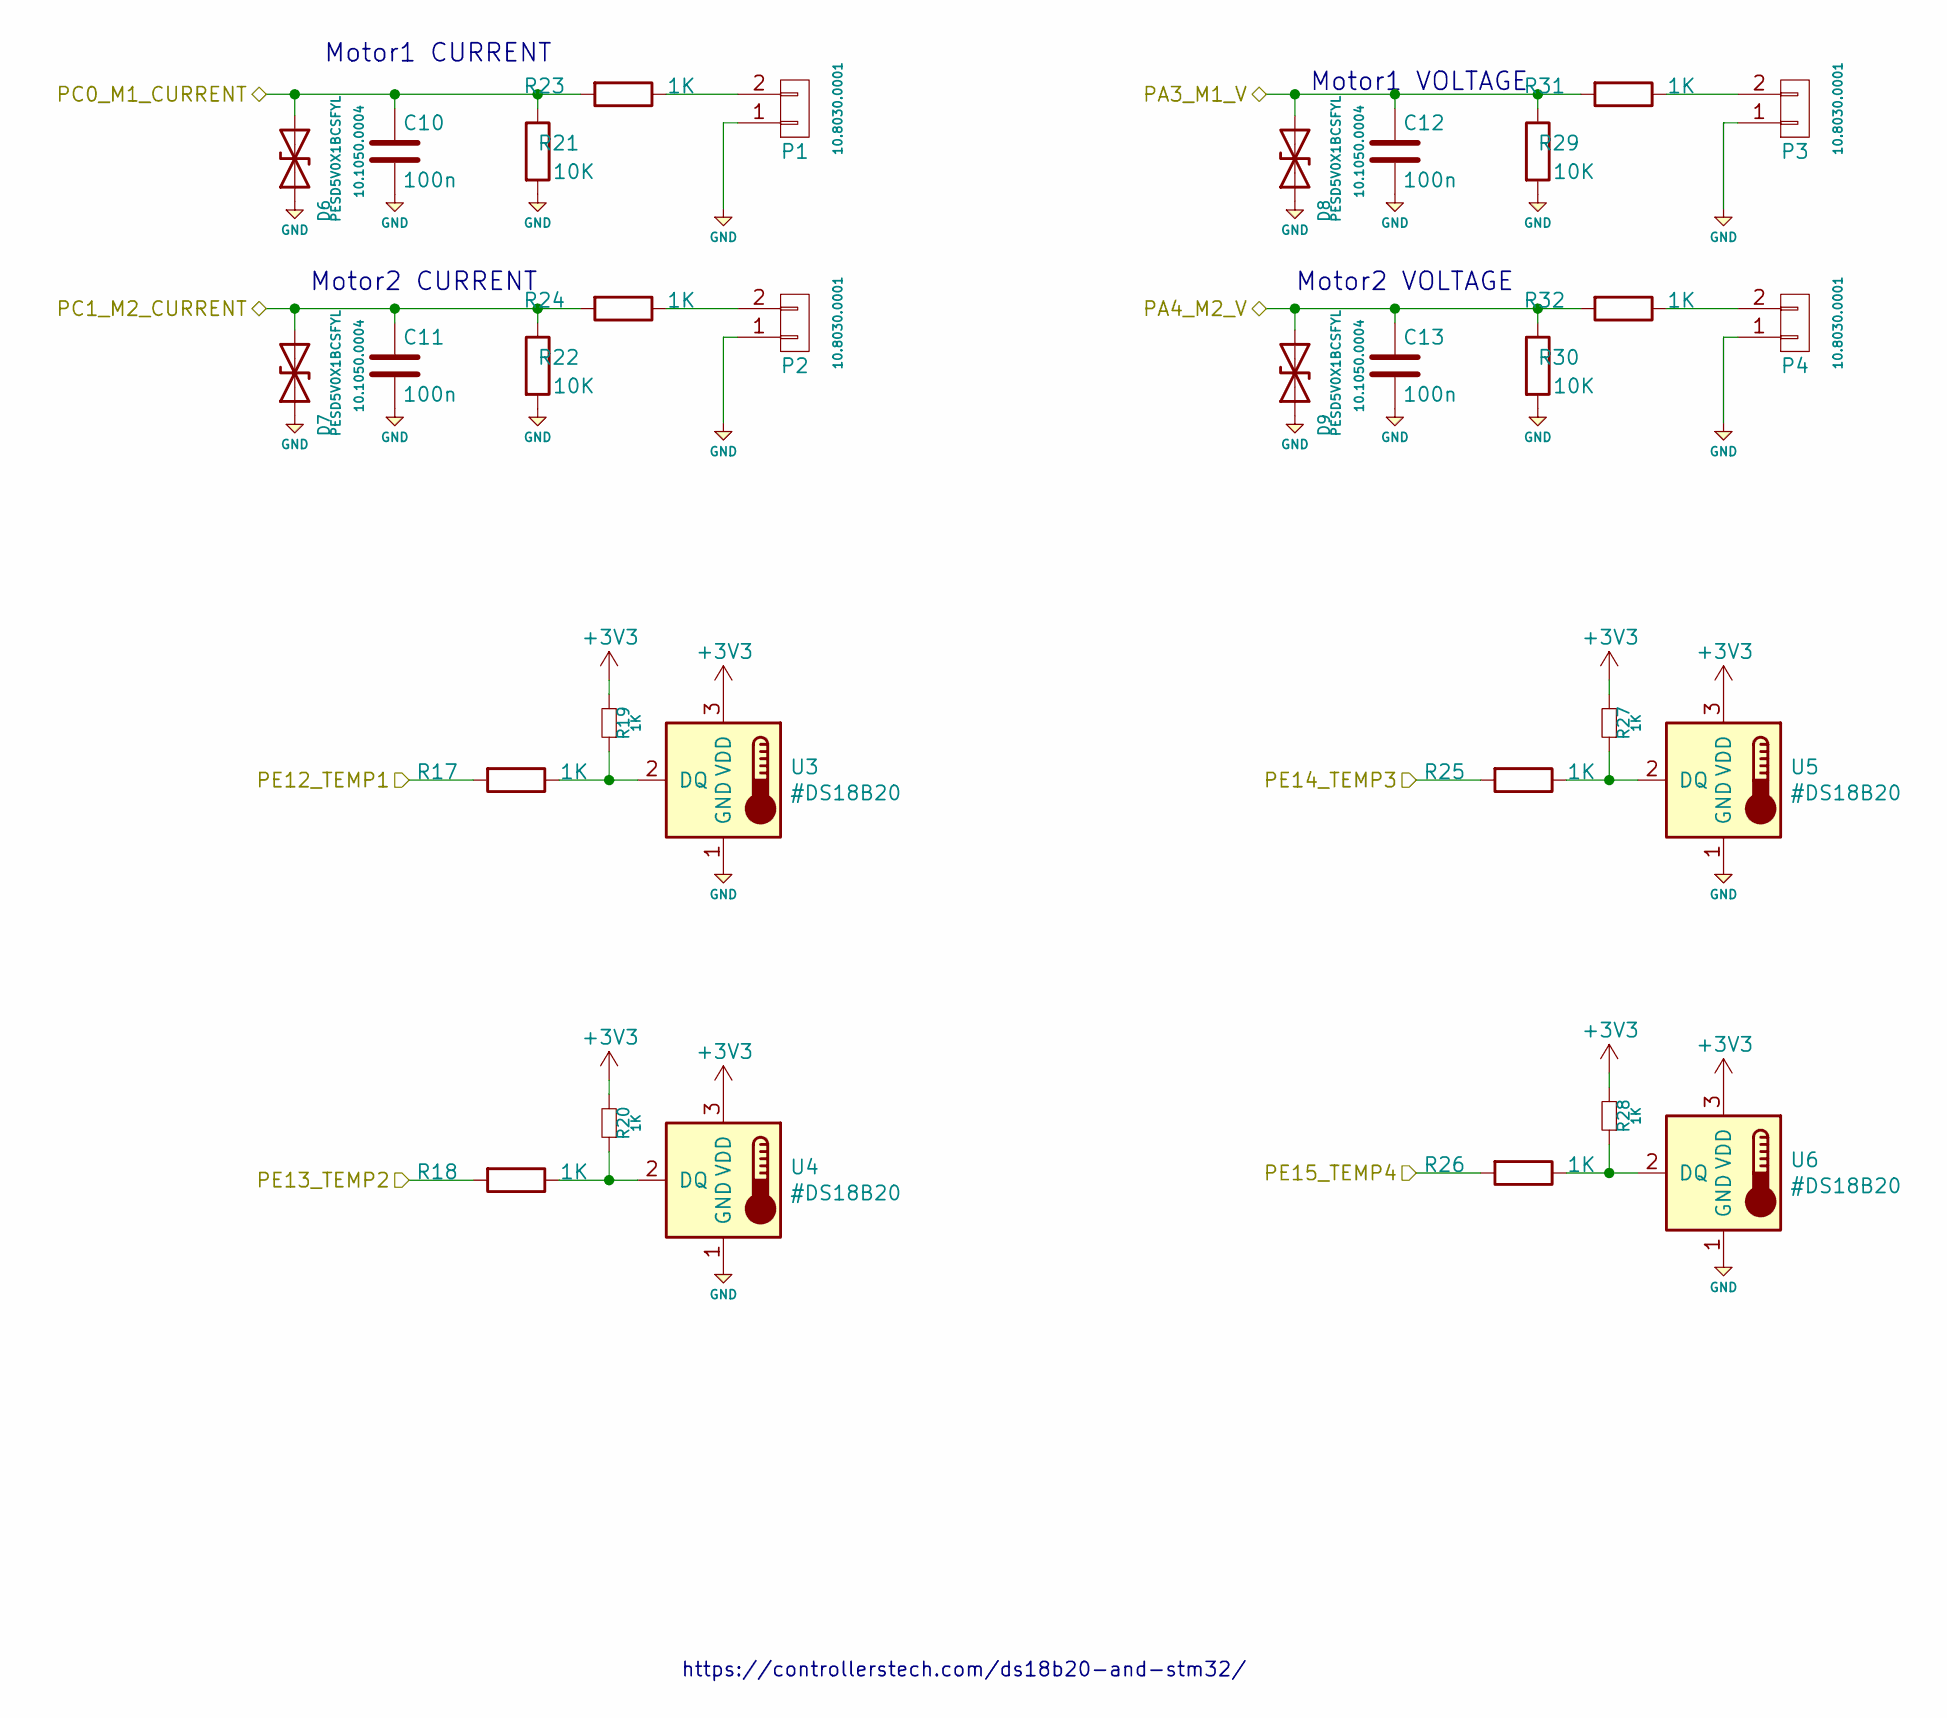
[picture p28: schematic Analog.kicad_sch, pNav32 Proto Board]

Parts:
C10, C11, C12, C13: 100n; C_0603_1608Metric; LCSC C14663
D6, D7, D8, D9: PESD5V0X1BCSFYL; D_0603_1608Metric; LCSC C2443412
P1, P2, P3, P4: Molex_KK-254_AE-6410-02A_1x02_P2.54mm_Vertical
R17, R18, R23, R24, R25, R26, R31, R32: 1K; R_0603_1608Metric; LCSC C21190
R19, R20, R27, R28: 1K; R_0603_1608Metric; MPN CRCW06031K00FKEA; FARNELL 2122366
R21, R22, R29, R30: 10K; R_0603_1608Metric; LCSC C25804
U3, U4, U5, U6: #DS18B20; TO-92_Inline; MPN DS18B20

Connections:
+3V3: R19.2, R20.2, R27.2, R28.2, U3.3 (VDD), U4.3 (VDD), U5.3 (VDD), U6.3 (VDD); also elsewhere on the board
GND: C10.2, C11.2, C12.2, C13.2, D6.1 (A1), D7.1 (A1), D8.1 (A1), D9.1 (A1), P1.1, P2.1, P3.1, P4.1, R21.2, R22.2, R29.2, R30.2, U3.1 (GND), U4.1 (GND), U5.1 (GND), U6.1 (GND); also elsewhere on the board
unnamed: P1.2, R23.1
unnamed: P2.2, R24.1
unnamed: P3.2, R31.1
unnamed: P4.2, R32.1
unnamed: R17.1, R19.1, U3.2 (DQ)
unnamed: R18.1, R20.1, U4.2 (DQ)
unnamed: R25.1, R27.1, U5.2 (DQ)
unnamed: R26.1, R28.1, U6.2 (DQ)
PA3_M1_V: C12.1, D8.2 (A2), R29.1, R31.2; also elsewhere on the board
PA4_M2_V: C13.1, D9.2 (A2), R30.1, R32.2; also elsewhere on the board
PC0_M1_CURRENT: C10.1, D6.2 (A2), R21.1, R23.2; also elsewhere on the board
PC1_M2_CURRENT: C11.1, D7.2 (A2), R22.1, R24.2; also elsewhere on the board
PE12_TEMP1: R17.2; also elsewhere on the board
PE13_TEMP2: R18.2; also elsewhere on the board
PE14_TEMP3: R25.2; also elsewhere on the board
PE15_TEMP4: R26.2; also elsewhere on the board

Notes on the sheet:
Motor1 CURRENT
Motor1 VOLTAGE
Motor2 VOLTAGE
https://controllerstech.com/ds18b20-and-stm32/
Motor2 CURRENT

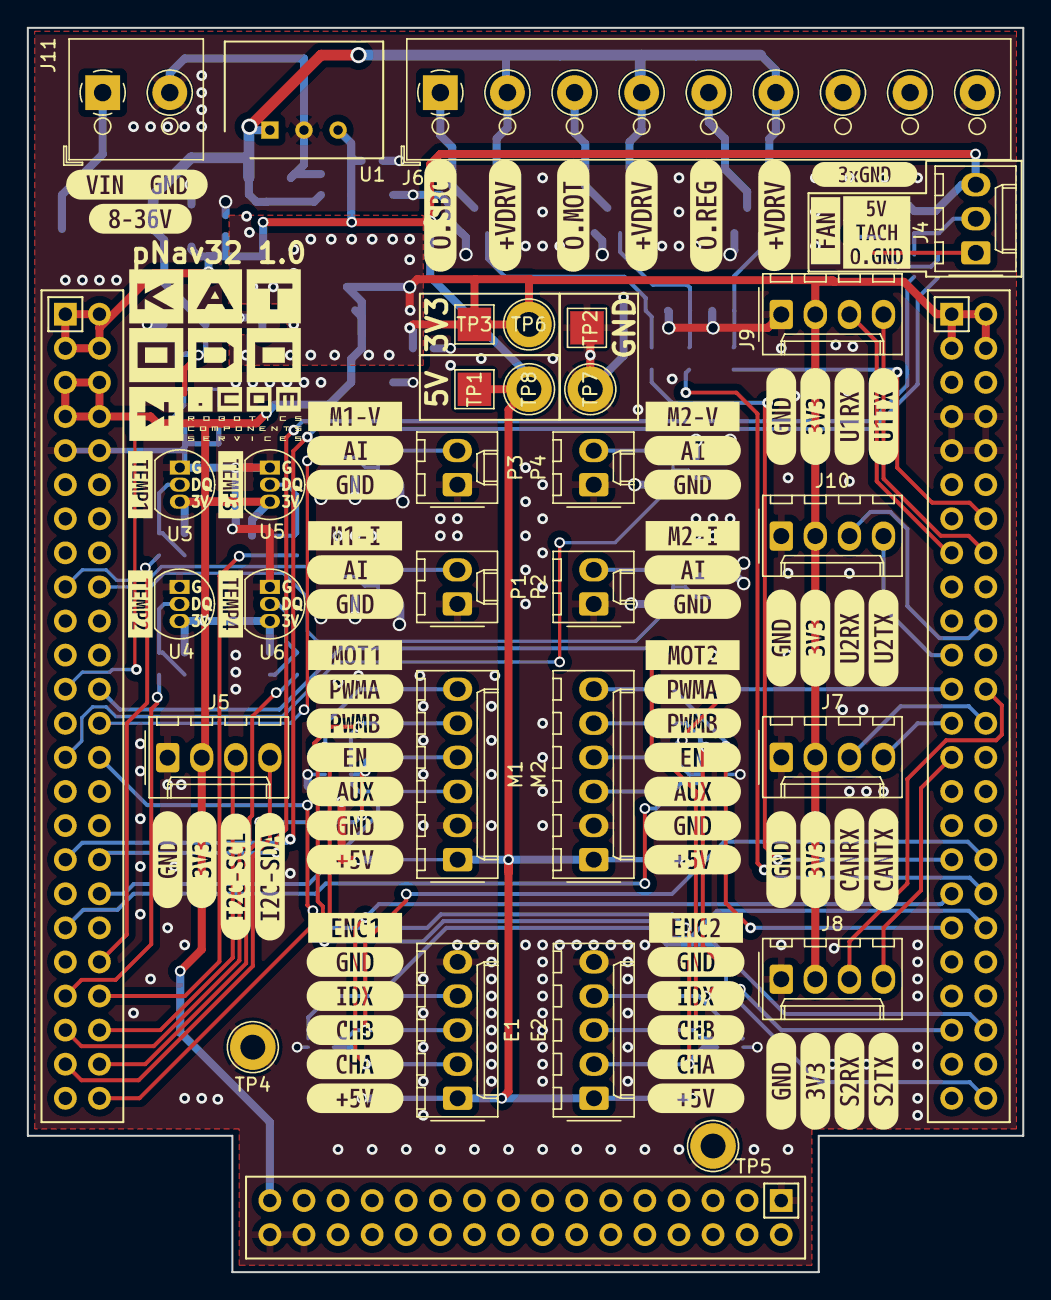
[picture p29: board RobotMotorController.kicad_pcb from above]

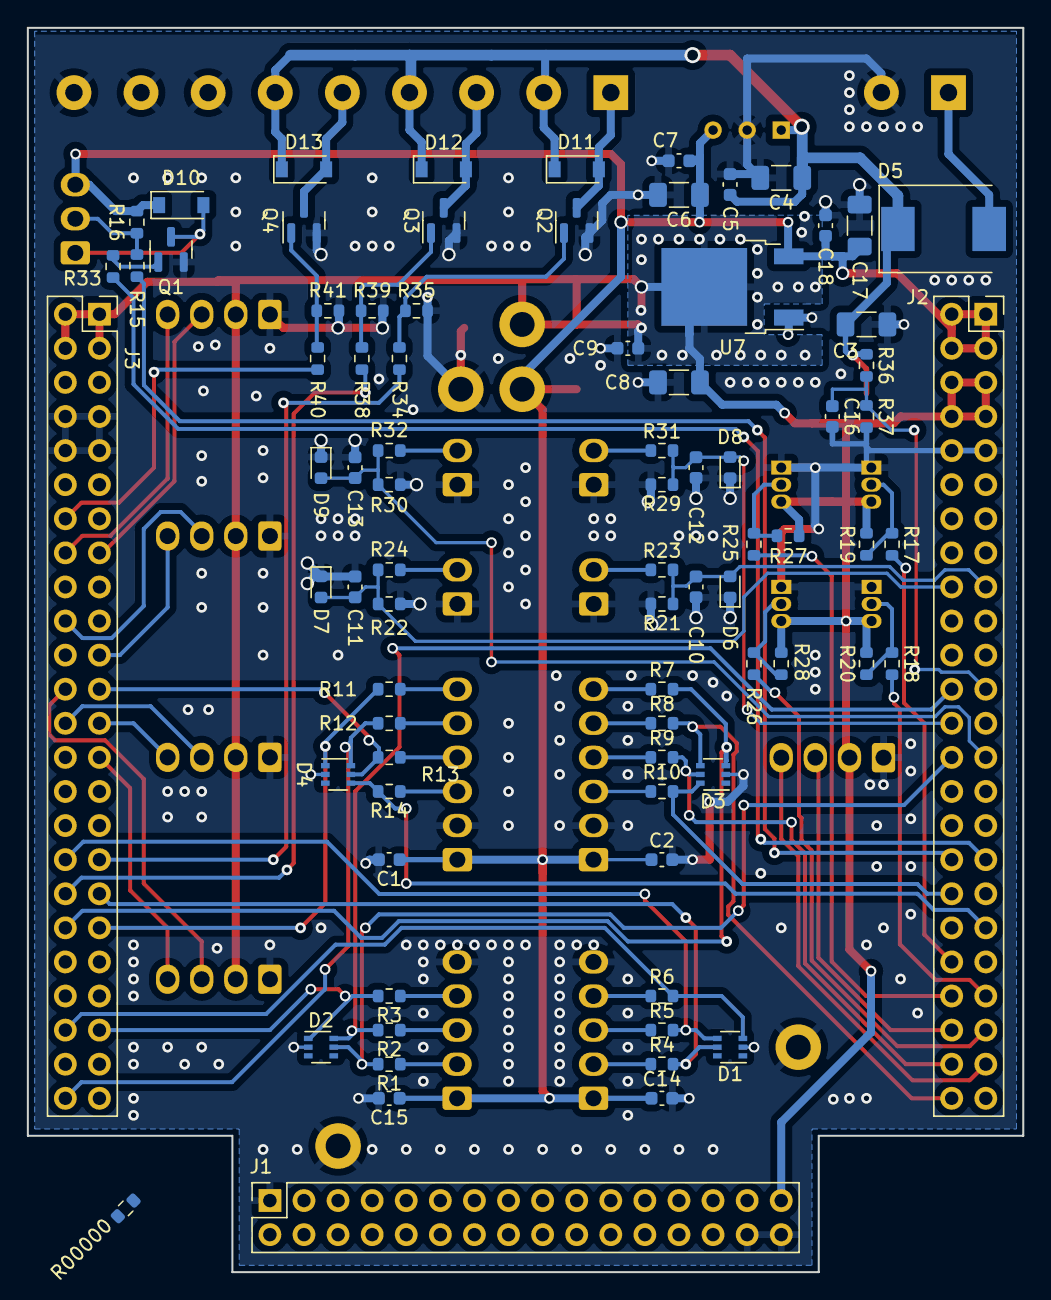
[picture p30: board RobotMotorController.kicad_pcb from below]

Board: 2 copper layers, 74.2 x 92.7 mm, 185 parts (81 on the bottom side), 74 nets.

Other parts of the board:
kibuzzard-63AACC29: G***; kibuzzard-63AACC29
kibuzzard-63AACC33: G***; kibuzzard-63AACC33
kibuzzard-63AACC58: G***; kibuzzard-63AACC58
kibuzzard-63AAD1E2: G***; kibuzzard-63AAD1E2
kibuzzard-63AAD7A3: G***; kibuzzard-63AAD7A3
kibuzzard-63AAD7D2: G***; kibuzzard-63AAD7D2
kibuzzard-63AAD7EB: G***; kibuzzard-63AAD7EB
kibuzzard-63AAD7FB: G***; kibuzzard-63AAD7FB
kibuzzard-63AAD203: G***; kibuzzard-63AAD203
kibuzzard-63AAD219: G***; kibuzzard-63AAD219
kibuzzard-63AAD233: G***; kibuzzard-63AAD233
kibuzzard-63AAD280: G***; kibuzzard-63AAD280
kibuzzard-63AAD289: G***; kibuzzard-63AAD289
kibuzzard-63AAD294: G***; kibuzzard-63AAD294
kibuzzard-63AB02C8: G***; kibuzzard-63AB02C8
kibuzzard-6394D4E3, kibuzzard-6394D4E3#2, kibuzzard-6394D4E3#3, kibuzzard-6394D4E3#4, kibuzzard-6394D4E3#5: G***; kibuzzard-6394D4E3
kibuzzard-6394D4F3, kibuzzard-6394D4F3#2, kibuzzard-6394D4F3#3, kibuzzard-6394D4F3#4, kibuzzard-6394D4F3#5: G***; kibuzzard-6394D4F3
kibuzzard-6394D8B5: G***; kibuzzard-6394D8B5
kibuzzard-6394D8C1: G***; kibuzzard-6394D8C1
kibuzzard-6394D9EA: G***; kibuzzard-6394D9EA
kibuzzard-6394D50C: G***; kibuzzard-6394D50C
kibuzzard-6394D52A: G***; kibuzzard-6394D52A
kibuzzard-6394D54D: G***; kibuzzard-6394D54D
kibuzzard-6394D57A: G***; kibuzzard-6394D57A
kibuzzard-6394D504: G***; kibuzzard-6394D504
kibuzzard-6394D524: G***; kibuzzard-6394D524
kibuzzard-6394D557: G***; kibuzzard-6394D557
kibuzzard-6394D572: G***; kibuzzard-6394D572
kibuzzard-6395EE3C: G***; kibuzzard-6395EE3C
kibuzzard-63934B9D, kibuzzard-63934B9D#2: G***; kibuzzard-63934B9D
kibuzzard-63934B92, kibuzzard-63934B92#2: G***; kibuzzard-63934B92
kibuzzard-63934BBB: G***; kibuzzard-63934BBB
kibuzzard-63934BC4: G***; kibuzzard-63934BC4
kibuzzard-63934BD1, kibuzzard-63934BD1#2: G***; kibuzzard-63934BD1
kibuzzard-63934BD9, kibuzzard-63934BD9#2: G***; kibuzzard-63934BD9
kibuzzard-63934BF1: G***; kibuzzard-63934BF1
kibuzzard-63934BF7: G***; kibuzzard-63934BF7
kibuzzard-639345B8: G***; kibuzzard-639345B8
kibuzzard-6393426E, kibuzzard-6393426E#2: G***; kibuzzard-6393426E
kibuzzard-6393456C, kibuzzard-6393456C#2: G***; kibuzzard-6393456C
kibuzzard-6393459E: G***; kibuzzard-6393459E
kibuzzard-6393473F, kibuzzard-6393473F#2: G***; kibuzzard-6393473F
kibuzzard-63934268, kibuzzard-63934268#2: G***; kibuzzard-63934268
kibuzzard-63934273, kibuzzard-63934273#2, kibuzzard-63934273#3, kibuzzard-63934273#4: G***; kibuzzard-63934273
kibuzzard-63934574, kibuzzard-63934574#2: G***; kibuzzard-63934574
kibuzzard-63934711: G***; kibuzzard-63934711
kibuzzard-63934735, kibuzzard-63934735#2: G***; kibuzzard-63934735
kibuzzard-63934749, kibuzzard-63934749#2: G***; kibuzzard-63934749
kibuzzard-63934750, kibuzzard-63934750#2: G***; kibuzzard-63934750
kibuzzard-63934760, kibuzzard-63934760#2: G***; kibuzzard-63934760
kibuzzard-63934774: G***; kibuzzard-63934774
