katodo/pNav32_RobotMotorController/Hardware/hBridge3620/hBridge3620_rev1.kicad_pcb

## KiCad design Hardware/hBridge3620/hBridge3620_rev1.kicad_pcb (2023-01-19)

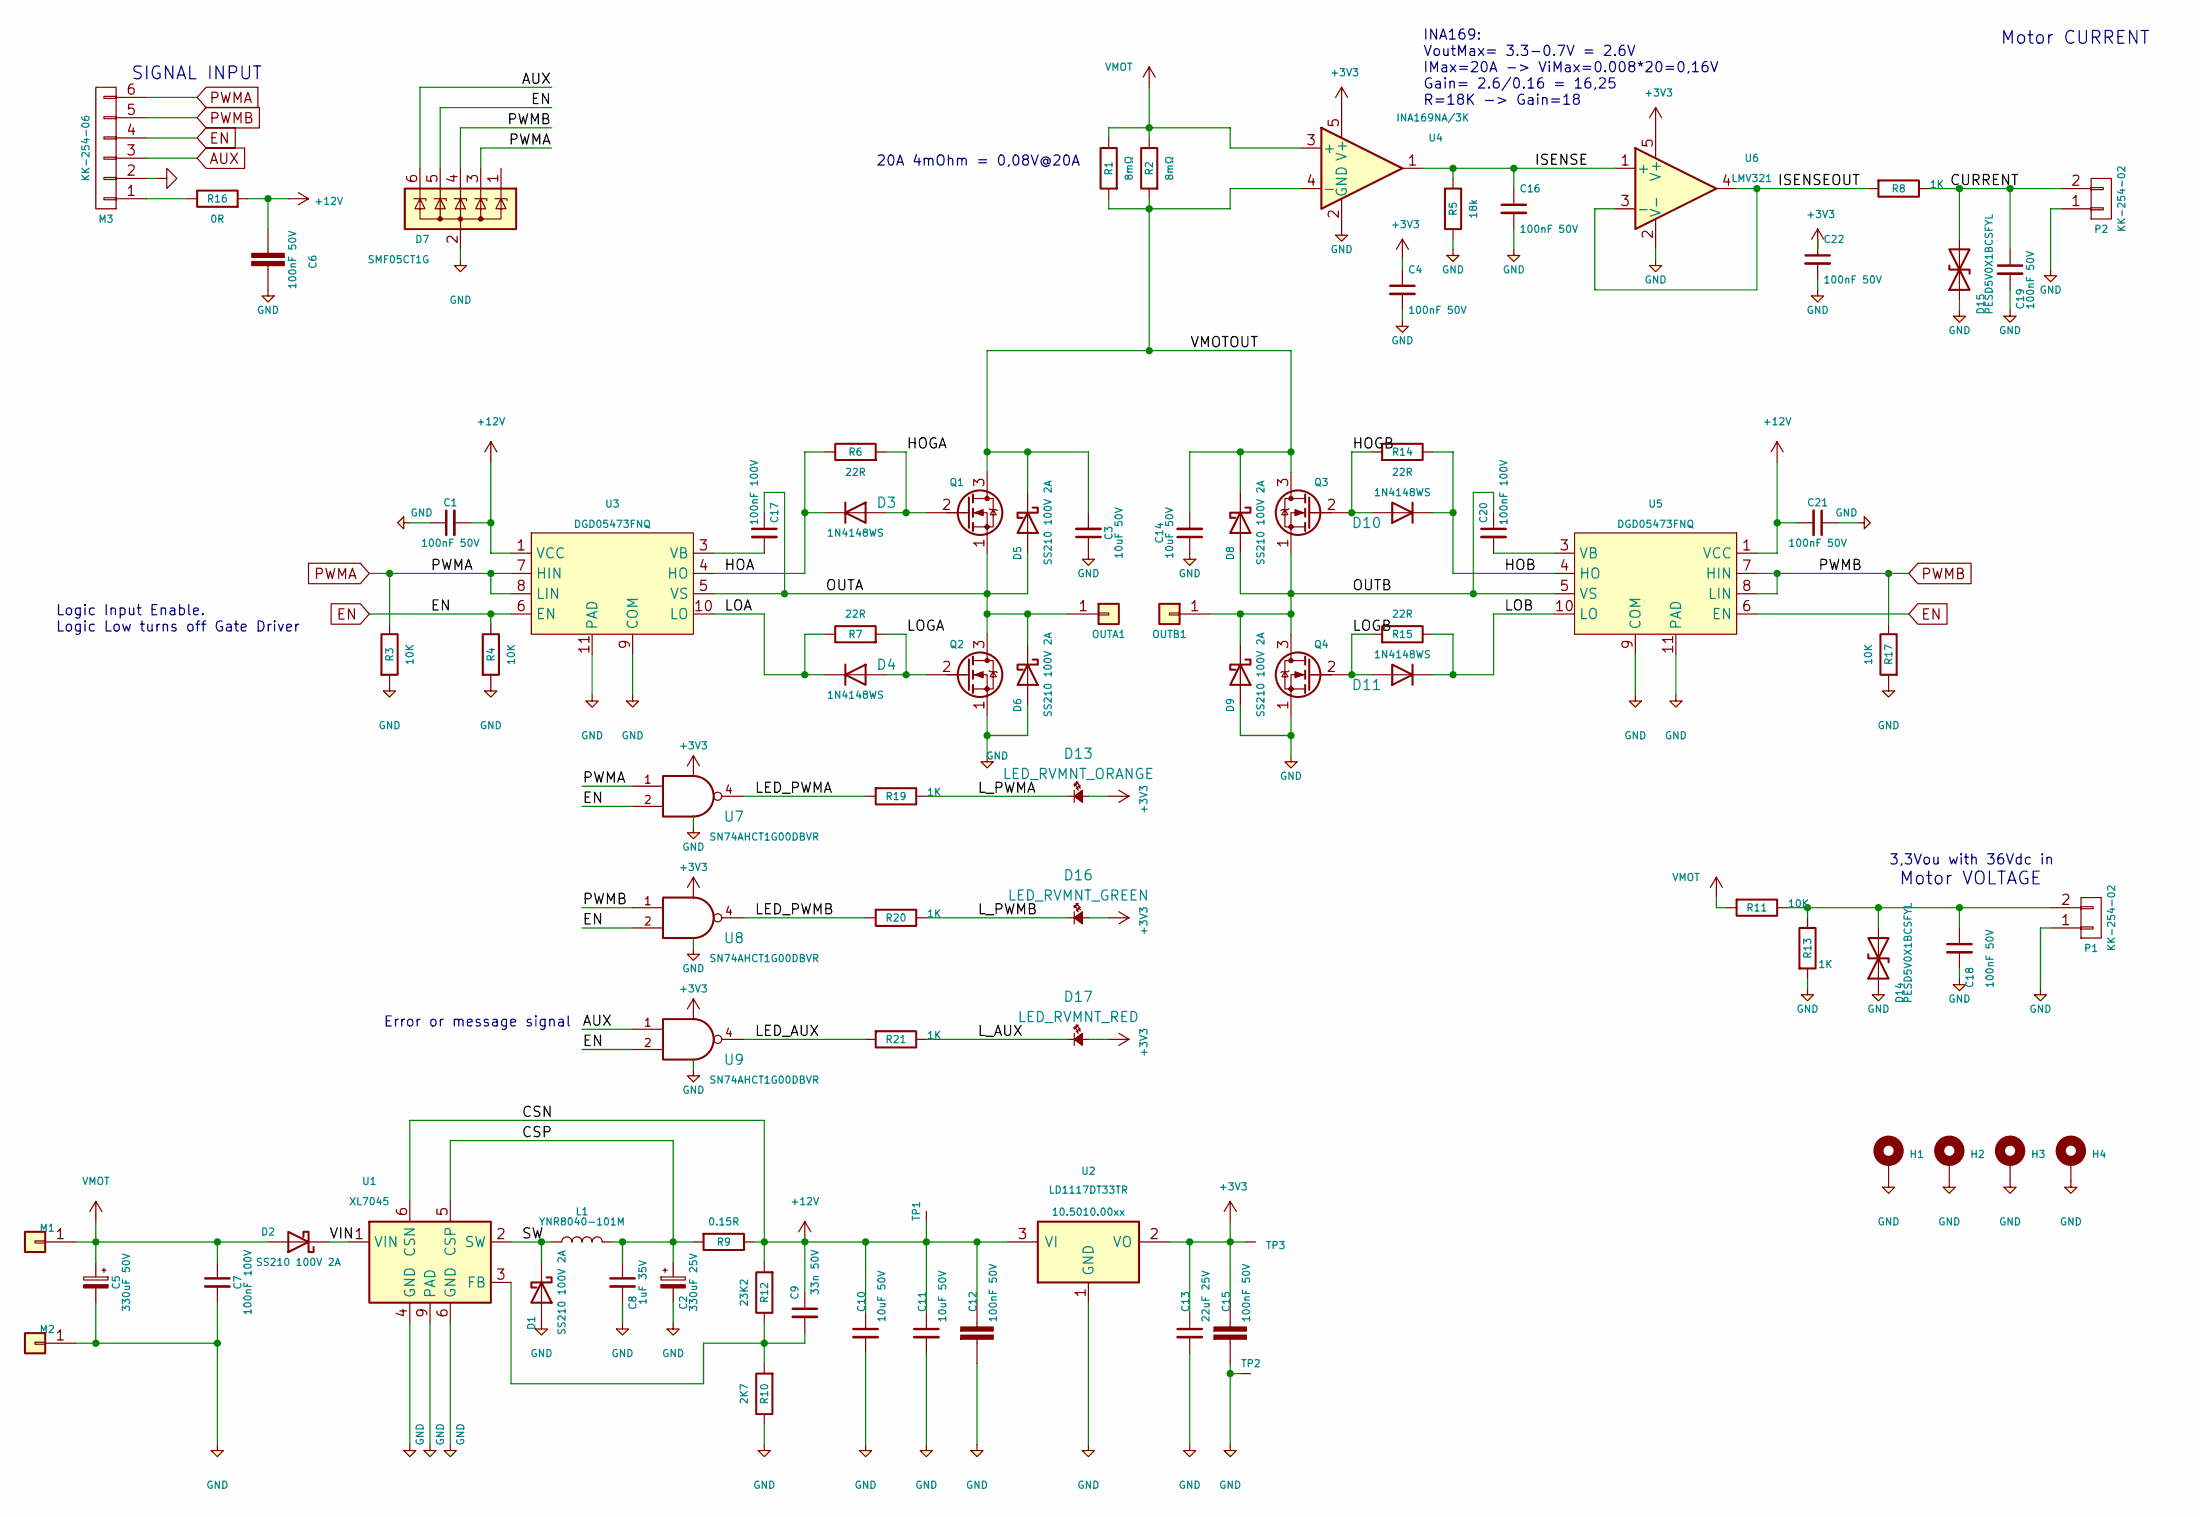
[picture p31: schematic hBridge3620_rev1.kicad_sch]

Parts:
C1, C4, C6, C12, C15, C16, C18, C19, C21, C22: 100nF 50V; C_0603_1608Metric; LCSC C14663
C2: 330uF 25V; CP_Radial_D10.0mm_P5.00mm
C3, C10, C11, C14: 10uF 50V; C_1206_3216Metric_Pad1.33x1.80mm_HandSolder; LCSC C13585
C5: 330uF 50V; CP_Radial_D12.5mm_P5.00mm
C7, C17, C20: 100nF 100V; C_0805_2012Metric; LCSC C28233
C8: 1uF 35V; C_0805_2012Metric; LCSC C28323
C9: 33n 50V; C_0603_1608Metric; LCSC C21117
C13: 22uF 25V; C_1206_3216Metric_Pad1.33x1.80mm_HandSolder; LCSC C12891
D1, D2, D5, D6, D8, D9: SS210 100V 2A; D_SMA; LCSC C14996
D3, D4, D10, D11: 1N4148WS; D_SOD-323; LCSC C2128
D7: SMF05CT1G; SOT-363_SC-70-6; LCSC C15879
D13: LED_RVMNT_ORANGE; LED_1206_3216Metric_ReverseMount_Hole1.8x2.4mm; MOUSER 859-LTST-C230KFKT
D14, D15: PESD5V0X1BCSFYL; D_0603_1608Metric; LCSC C2443412
D16: LED_RVMNT_GREEN; LED_1206_3216Metric_ReverseMount_Hole1.8x2.4mm; MOUSER 859-LTST-C230KGKT
D17: LED_RVMNT_RED; LED_1206_3216Metric_ReverseMount_Hole1.8x2.4mm; MOUSER 859-LTST-C230KRKT
H1, H2, H3, H4: MountingHole_Pad; MountingHole_3.2mm_M3_Pad_Via
L1: YNR8040-101M; L_Taiyo-Yuden_NR-80xx; LCSC C341083
M1, M2: HIGHCURRENTPAD2; SolderWire-2.5sqmm_1x01_D2.4mm_OD4.4mm
M3: KK-254-06; Molex_KK-254_AE-6410-06A_1x06_P2.54mm_Vertical
OUTA1: HIGHCURRENTPAD2; SolderWire-2.5sqmm_1x01_D2.4mm_OD4.4mm
OUTB1: HIGHCURRENTPAD2; SolderWire-2.5sqmm_1x01_D2.4mm_OD4.4mm
P1, P2: KK-254-02; Molex_KK-254_AE-6410-02A_1x02_P2.54mm_Vertical
Q1, Q2, Q3, Q4: RU6888M; DFN-8-1EP_5.55x5.2mm_P1.27mm_EP4.12x4.6mm_MOSFET_3PIN; LCSC C180959
R1, R2: 8mΩ; R_2512_6332Metric; LCSC C469375
R3, R4, R11, R17: 10K; R_0603_1608Metric; LCSC C25804
R5: 18k; R_0603_1608Metric; LCSC C25810
R6, R7, R14, R15: 22R; R_0603_1608Metric; LCSC C23345
R8, R13, R19, R20, R21: 1K; R_0603_1608Metric; LCSC C21190
R9: 0.15R; R_1206_3216Metric; LCSC C37936
R10: 2K7; R_0603_1608Metric; LCSC C13167
R12: 23K2; R_0603_1608Metric; LCSC C2930078
R16: 0R; R_0603_1608Metric; LCSC C21189
TP1, TP2, TP3: TESTPAD; TestPoint_Pad_2.5x2.5mm
U1: XL7045; SOIC-8-1EP_3.9x4.9mm_P1.27mm_EP2.29x3mm; LCSC C126474
U2: LD1117DT33TR; TO-252-2; LCSC C36395
U3, U5: DGD05473FNQ; U-DFN3030-10_3.1x3.1mm_P0.5mm_EP1.8x2.6mm_ThermalVias; LCSC C2677131
U4: INA169NA/3K; SOT-23-5; LCSC C44322
U6: LMV321; SOT-23-5; LCSC C7972
U7, U8, U9: SN74AHCT1G00DBVR; SOT-23-5; LCSC C473380

Connections:
+3V3: C4.1, C13.1, C15.1, C22.1, D13.2, D16.2, D17.2, TP3.1 (TP), U2.2 (VO), U4.5 (V+), U6.5 (V+), U7.5 (VCC), U8.5 (VCC), U9.5 (VCC)
/CSP: C2.1, C8.1, L1.2, R9.2, U1.5 (CSP)
/CURRENT: C19.1, D15.2 (A2), P2.2, R8.1
/HOA: D3.1 (K), R6.1, U3.4 (HO)
/HOB: D10.1 (K), R14.1, U5.4 (HO)
/HOGA: D3.2 (A), Q1.2 (G), R6.2
/HOGB: D10.2 (A), Q3.2 (G), R14.2
/ISENSE: C16.1, R5.1, U4.1, U6.1 (+)
/ISENSEOUT: R8.2, U6.3 (-), U6.4
/LED_AUX: R21.2, U9.4
/LED_PWMA: R19.2, U7.4
/LED_PWMB: R20.2, U8.4
/LOA: D4.1 (K), R7.1, U3.10 (LO)
/LOB: D11.1 (K), R15.1, U5.10 (LO)
/LOGA: D4.2 (A), Q2.2 (G), R7.2
/LOGB: D11.2 (A), Q4.2 (G), R15.2
/L_AUX: D17.1, R21.1
/L_PWMA: D13.1, R19.1
/L_PWMB: D16.1, R20.1
/OUTA: C17.1, D5.2 (A), D6.1 (K), OUTA1.1, Q1.1 (S), Q2.3 (D), U3.5 (VS)
/OUTB: C20.1, D8.2 (A), D9.1 (K), OUTB1.1, Q3.1 (S), Q4.3 (D), U5.5 (VS)
/SW: D1.1 (K), L1.1, U1.2 (SW)
/VIN: D2.1 (K), U1.1 (VIN)
/VMOTOUT: C3.2, C14.2, D5.1 (K), D8.1 (K), Q1.3 (D), Q3.3 (D), R1.2, R2.2, U4.4 (-)
AUX: D7.6 (K), M3.3, U9.1
EN: D7.5 (K), M3.4, R4.1, U3.6 (EN), U5.6 (EN), U7.2, U8.2, U9.2
unnamed: C9.2, R10.2, R12.1, U1.3 (FB)
unnamed: C17.2, U3.3 (VB)
unnamed: C18.1, D14.2 (A2), P1.2, R11.1, R13.1
unnamed: C20.2, U5.3 (VB)
unnamed: M3.1, R16.1
PWMA: D7.3 (K), M3.6, R3.1, U3.7 (HIN), U3.8 (LIN), U7.1
PWMB: D7.4 (K), M3.5, R17.1, U5.7 (HIN), U5.8 (LIN), U8.1
VMOT: C5.1, C7.1, D2.2 (A), M1.1, R1.1, R2.1, R11.2, U4.3 (+)

Notes on the sheet:
3,3Vou with 36Vdc in
Logic Input Enable. Logic Low turns off Gate Driver
Motor VOLTAGE
Motor CURRENT
20A 4mOhm = 0,08V@20A
INA169: VoutMax= 3.3-0.7V = 2.6V IMax=20A -> ViMax=0.008*20=0,16V Gain= 2.6/0.16 = 16,25 R=18K -> Gain=18
Error or message signal
SIGNAL INPUT

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
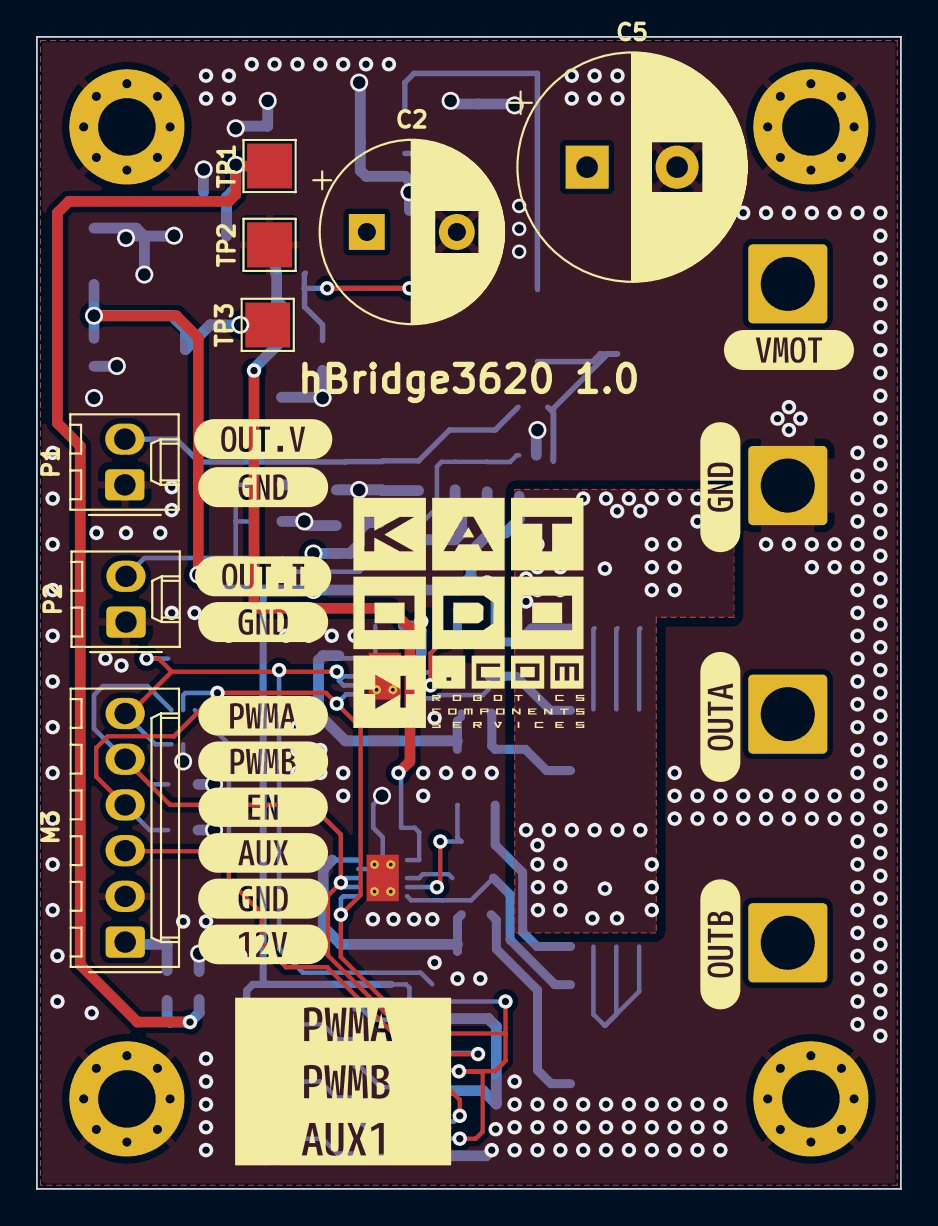
[picture p32: board hBridge3620_rev1.kicad_pcb from above]

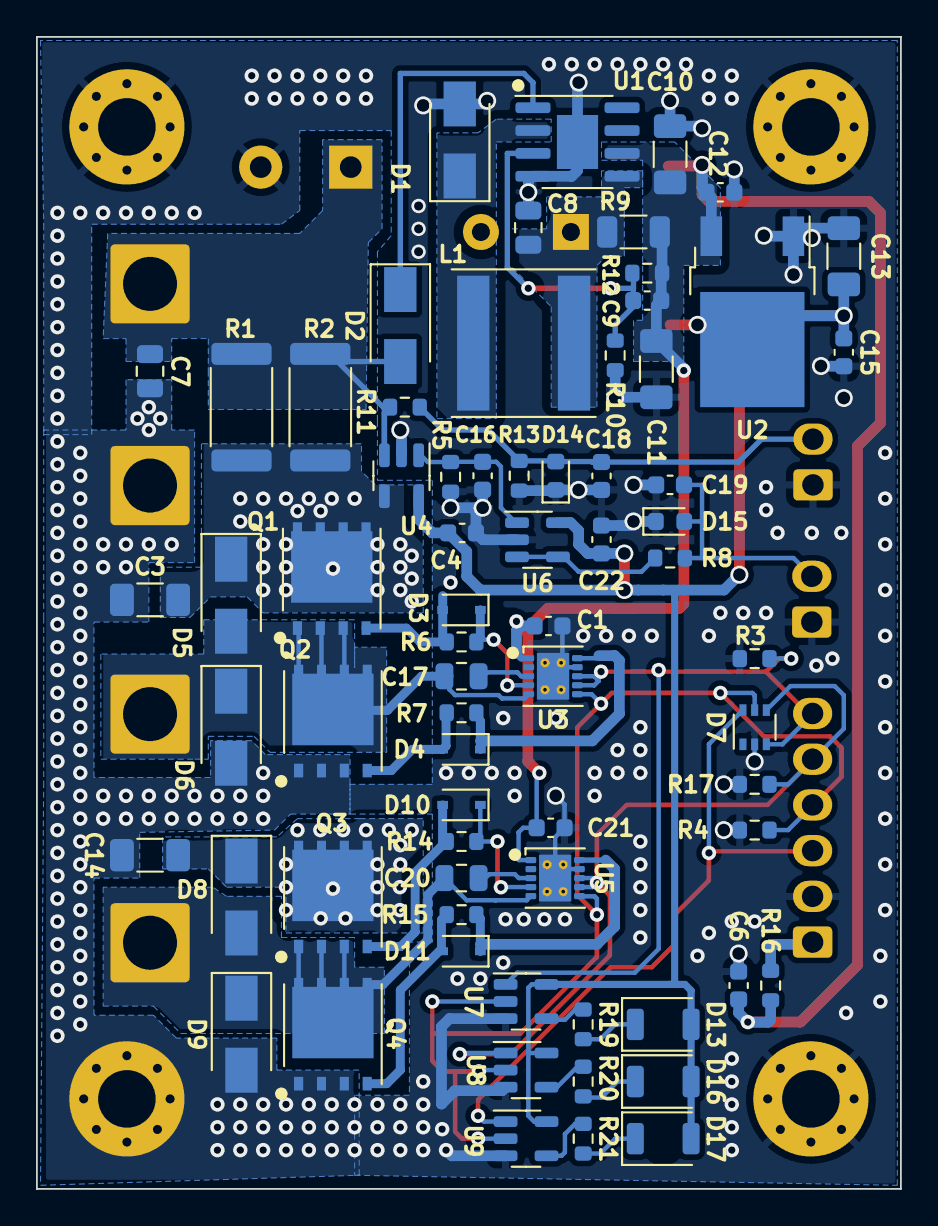
[picture p33: board hBridge3620_rev1.kicad_pcb from below]

Board: 2 copper layers, 48.0 x 64.0 mm, 101 parts (70 on the bottom side), 36 nets.

Other parts of the board:
kibuzzard-63AF517B: G***; kibuzzard-63AF517B
kibuzzard-63AF5189: G***; kibuzzard-63AF5189
kibuzzard-63B18A56: G***; kibuzzard-63B18A56
kibuzzard-63B18C51: G***; kibuzzard-63B18C51
kibuzzard-63B18C79: G***; kibuzzard-63B18C79
kibuzzard-63B18C86: G***; kibuzzard-63B18C86
kibuzzard-63B83704: G***; kibuzzard-63B83704
kibuzzard-63934BD9, kibuzzard-63934BD9#2, kibuzzard-63934BD9#3: G***; kibuzzard-63934BD9
kibuzzard-6393473F: G***; kibuzzard-6393473F
kibuzzard-63934735: G***; kibuzzard-63934735
kibuzzard-63934749: G***; kibuzzard-63934749
kibuzzard-63934750: G***; kibuzzard-63934750
kibuzzard-63934760: G***; kibuzzard-63934760
