katodo/pNav32_RobotMotorController/Firmware/Core/Src/main.c

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
/* Includes ------------------------------------------------------------------*/
#include "main.h"
#include "cmsis_os.h"
#include "adc.h"
#include "can.h"
#include "crc.h"
#include "dma.h"
#include "i2c.h"
#include "rng.h"
#include "spi.h"
#include "tim.h"
#include "usart.h"
#include "usb_device.h"
#include "gpio.h"

/* USER CODE BEGIN Includes */
#include "globals.h"
#include "motors.h"
#include "encoder.h"

/* USER CODE END Includes */


void SystemClock_Config(void);
void MX_FREERTOS_Init(void);
/* USER CODE BEGIN 0 */
extern ADC_HandleTypeDef hadc1;
extern DMA_HandleTypeDef hdma_adc1;

/* USER CODE END 0 */

/**
  * @brief  The application entry point.
  * @retval int
  */
int main(void)
{

  /* MCU Configuration--------------------------------------------------------*/

  /* Reset of all peripherals, Initializes the Flash interface and the Systick. */
  HAL_Init();

  /* Configure the system clock */
  SystemClock_Config();

  /* Initialize all configured peripherals */
  MX_GPIO_Init();
  MX_DMA_Init();
  MX_TIM1_Init();
  MX_TIM2_Init();
  MX_TIM8_Init();
  MX_I2C2_Init();
  MX_SPI1_Init();
  MX_USART1_UART_Init();
  MX_ADC1_Init();
  MX_ADC3_Init();
  MX_TIM3_Init();
  MX_TIM4_Init();
  MX_UART5_Init();
  MX_CRC_Init();
  MX_RNG_Init();
  MX_TIM14_Init();
  MX_CAN1_Init();
  MX_USART2_UART_Init();
  MX_TIM5_Init();
  /* USER CODE BEGIN 2 */


  HAL_TIM_Base_Start_IT(&htim5);

  // 2) Avvia il PWM su TIM8
  MotorControl_StartPWM();

  // Imposta i motori inizialmente fermi ma enable=true
  MotorControl_SetMotors(0.0f, 0.0f, true, true, false, false);


  // Inizializza il modulo encoder
  ENC_Init();

  /* USER CODE END 2 */

  /* Init scheduler */
  osKernelInitialize();

  /* Call init function for freertos objects (in cmsis_os2.c) */
  MX_FREERTOS_Init();

  /* Start scheduler */
  osKernelStart();

  /* We should never get here as control is now taken by the scheduler */

  /* Infinite loop */
  /* USER CODE BEGIN WHILE */

  while (1)
  {
    /* USER CODE END WHILE */

    /* USER CODE BEGIN 3 */
  }
  /* USER CODE END 3 */
}

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
/* USER CODE BEGIN 4 */


/**
  * @brief  Conversion complete callback in non blocking mode
  * @param  hadc: ADC handle
  * @note   This example shows a simple way to report end of conversion
  *         and get conversion result. You can add your own implementation.
  * @retval None
  */
void HAL_ADC_ConvCpltCallback(ADC_HandleTypeDef *hadc)
{
  /* Update status variable of DMA transfer */
  //ubDmaTransferStatus = 1;

  /* Set LED depending on DMA transfer status */
  /* - Turn-on if DMA transfer is completed */
  /* - Turn-off if DMA transfer is not completed */
	dmaTransferComplete = 1;
}

/**
  * @brief  Conversion DMA half-transfer callback in non blocking mode
  * @note   This example shows a simple way to report end of conversion
  *         and get conversion result. You can add your own implementation.
  * @retval None
  */
void HAL_ADC_ConvHalfCpltCallback(ADC_HandleTypeDef *hadc)
{
  /* Set LED depending on DMA transfer status */
  /* - Turn-on if DMA transfer is completed */
  /* - Turn-off if DMA transfer is not completed */
	dmaHalfTransferComplete=1;
}


/* USER CODE END 4 */

/**
  * @brief  Period elapsed callback in non blocking mode
  * @note   This function is called  when TIM10 interrupt took place, inside
  * HAL_TIM_IRQHandler(). It makes a direct call to HAL_IncTick() to increment
  * a global variable "uwTick" used as application time base.
  * @param  htim : TIM handle
  * @retval None
  */
void HAL_TIM_PeriodElapsedCallback(TIM_HandleTypeDef *htim)
{
  /* USER CODE BEGIN Callback 0 */
	if (htim->Instance == TIM5)
	{
		// Codice da eseguire ogni 1ms
		ENC_Update();
	}

  /* USER CODE END Callback 0 */
  if (htim->Instance == TIM10) {
    HAL_IncTick();
  }
}

/**
  * @brief  This function is executed in case of error occurrence.
  * @retval None
  */
void Error_Handler(void)
{
  /* USER CODE BEGIN Error_Handler_Debug */
  /* User can add his own implementation to report the HAL error return state */
  __disable_irq();
  while (1)
  {
  }
  /* USER CODE END Error_Handler_Debug */
}

#ifdef  USE_FULL_ASSERT
/**
  * @brief  Reports the name of the source file and the source line number
  *         where the assert_param error has occurred.
  * @param  file: pointer to the source file name
  * @param  line: assert_param error line source number
  * @retval None
  */
void assert_failed(uint8_t *file, uint32_t line)
{
  /* USER CODE BEGIN 6 */
  /* User can add his own implementation to report the file name and line number,
     ex: printf("Wrong parameters value: file %s on line %d\r\n", file, line) */
  /* USER CODE END 6 */
}
#endif /* USE_FULL_ASSERT */
