katodo/pNav32_RobotMotorController/Hardware/RobotMotorController/Doc/F407VE板- LCD显示例程/USER/main.c

#include "sys.h"
#include "delay.h"
#include "usart.h"
#include "led.h"
#include "lcd.h"


//LCD显示实验-库函数版本
//STM32F4工程模板-库函数版本
//淘宝店铺：http://mcudev.taobao.com		

int main(void)
{ 
 	u8 x=0;
	u8 lcd_id[12];				//存放LCD ID字符串
	NVIC_PriorityGroupConfig(NVIC_PriorityGroup_2);//设置系统中断优先级分组2
	delay_init(168);      //初始化延时函数
	uart_init(115200);		//初始化串口波特率为115200
	
	LED_Init();					  //初始化LED
 	LCD_Init();           //初始化LCD FSMC接口
	POINT_COLOR=RED;      //画笔颜色：红色
	sprintf((char*)lcd_id,"LCD ID:%04X",lcddev.id);//将LCD ID打印到lcd_id数组。				 	
  	while(1) 
	{		 
		switch(x)
		{
			case 0:LCD_Clear(WHITE);break;
			case 1:LCD_Clear(BLACK);break;
			case 2:LCD_Clear(BLUE);break;
			case 3:LCD_Clear(RED);break;
			case 4:LCD_Clear(MAGENTA);break;
			case 5:LCD_Clear(GREEN);break;
			case 6:LCD_Clear(CYAN);break; 
			case 7:LCD_Clear(YELLOW);break;
			case 8:LCD_Clear(BRRED);break;
			case 9:LCD_Clear(GRAY);break;
			case 10:LCD_Clear(LGRAY);break;
			case 11:LCD_Clear(BROWN);break;
		}
		POINT_COLOR=RED;	  
		LCD_ShowString(30,40,210,24,24,"Mcudev STM32F4");	
		LCD_ShowString(30,70,200,16,16,"TFTLCD 3.2");
		LCD_ShowString(30,90,200,16,16,"Mcudev.taobao");
 		LCD_ShowString(30,110,200,16,16,lcd_id);		//显示LCD ID	      					 
		LCD_ShowString(30,130,200,12,12,"2015/5/4");	      					 
	  x++;
		if(x==12)x=0;
		LED0=!LED0;	 
		delay_ms(1000);	
	} 
}
