katodo/pNav32_RobotMotorController/(commit log)

2022-10-27 test with publishing o different messages... FAIL...
    [pNav32.ioc]
2022-11-27 Solved problem on Battery message publishing
2022-12-29 Hardware release 1.0 produced by JLCPCB
    [Analog.kicad_sch, BOM-RobotMotorController.csv, BridgeLowPower.kicad_sch, RoboPonteDual.kicad_sch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]
2022-12-29 changed 1N4148 JLCPCB code and value of R1 and R00000 resistor.
    [BridgeLowPower.kicad_sch, RoboPonteDual.kicad_sch, RobotMotorController.kicad_pcb, motor.kicad_sch, supply.kicad_sch]
2023-01-07 hBridge3620 V1.0
    [Analog.kicad_sch, BOM-RobotMotorController.csv, BOM-hBridge3620.csv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]
2023-01-19 varius improvement
    [RobotMotorController.kicad_pcb, RobotMotorController.kicad_sch, hBridge3620.kicad_pcb]
2023-01-26 ADC init completed
    [RobotMotorController.kicad_sch, supply.kicad_sch]
2025-01-06 General update, first encoder implementation
    [Analog.kicad_sch, BOM-hBridge3620.csv, RobotMotorController.kicad_sch, cpu.kicad_sch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]
2025-01-12 first test of encoder implementation with ROS2
2025-01-23 lettura durata impulso inizia a funzionare ma con troppo errore
    [encoder.c, encoder.h, globals.c, globals.h, main.c, pNav32.ioc]
2025-01-23 Aggiornamento Kicad
    [RobotMotorController.kicad_pcb]
2025-01-27 Calcolo di impulse_time resettando ogni volta il contatore
    [encoder.c]
